LollobolUni/muon-time-dilation/mechanics/drawings/3DP-301_Block_enclosure_inserts.pdf

### TOP VIEW (looking down -Z) — inserts marked in red

Part file | 3DP-301_Block_enclosure.step
Part qty in order | 1
Material | 9600 Resin (white)
Insert type (JLC3DP table) | Type 1 — TTH-M3*6.25-HD4.7

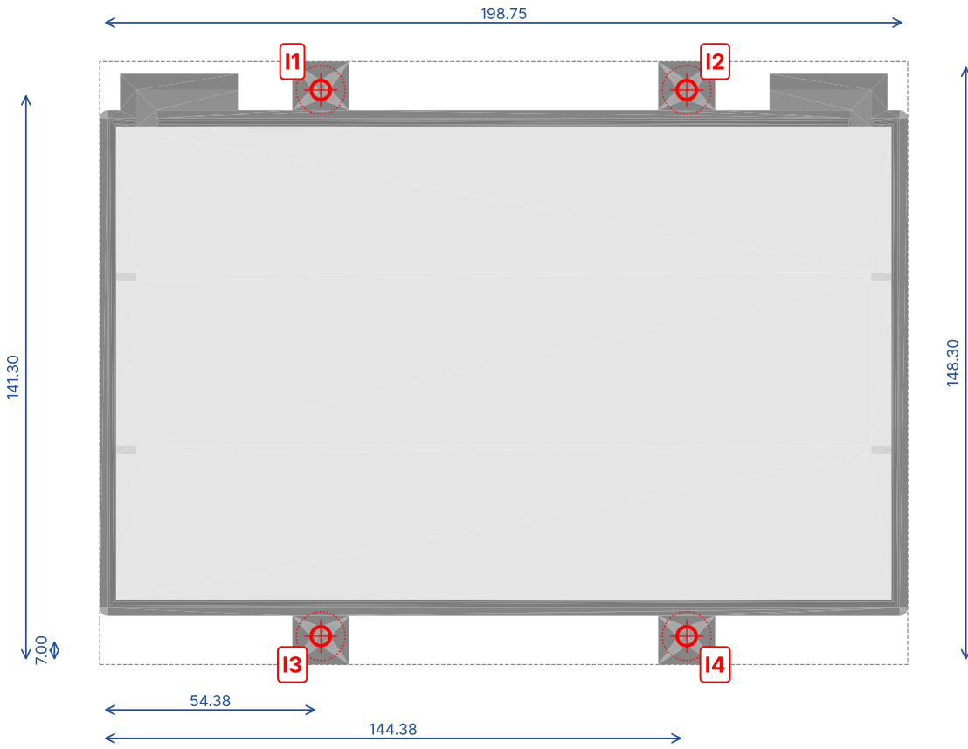
[picture p8: figure]

Thread | M3 (ID 3.0, OD 4.73, L 6.25)
Inserts per part | 4 (I1–I4)
Total inserts for this file | 4
Hole as modelled | Ø4.7 x 1.0 boss + Ø4.0 x 7.0 below = 8.0 total
Insert direction | From top (+Z), flush with face Z = 48.58
Insert | X from left edge Y from bottom edge | Z face
I1 | 54.38 | 141.30 | 48.58
I2 | 144.38 | 141.30 | 48.58
I3 | 54.38 | 7.00 | 48.58
I4 | 144.38 | 7.00 | 48.58

SECTION at Y = 141.30 from bottom edge (through I1/I2) — insert holes open upward

# 3DP-301 Block enclosure — threaded insert drawing (JLC3DP threaded insert service)

Lorenzo Bologna — muon-time-dilation project · units mm · 3DP-301_Block_enclosure.step · drawing generated from the uploaded model, same coordinates

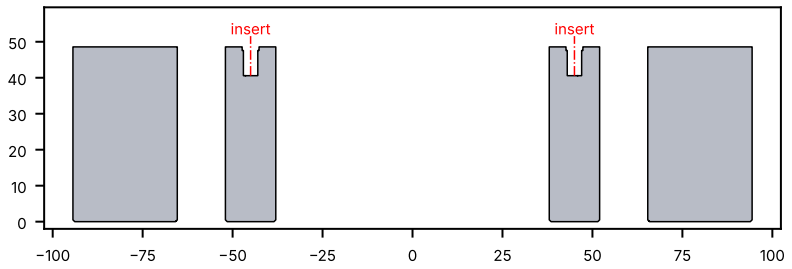
[picture p9: figure]
insert

Notes: install the 4 inserts I1-I4 flush with the face, from the open (+Z) side. No inserts in other holes. Holes = JLC3DP Type 1 (B 1.0, C 7.0, D 8.0).
