LollobolUni/muon-time-dilation/mechanics/assemblies/Tile_module_assembly.step

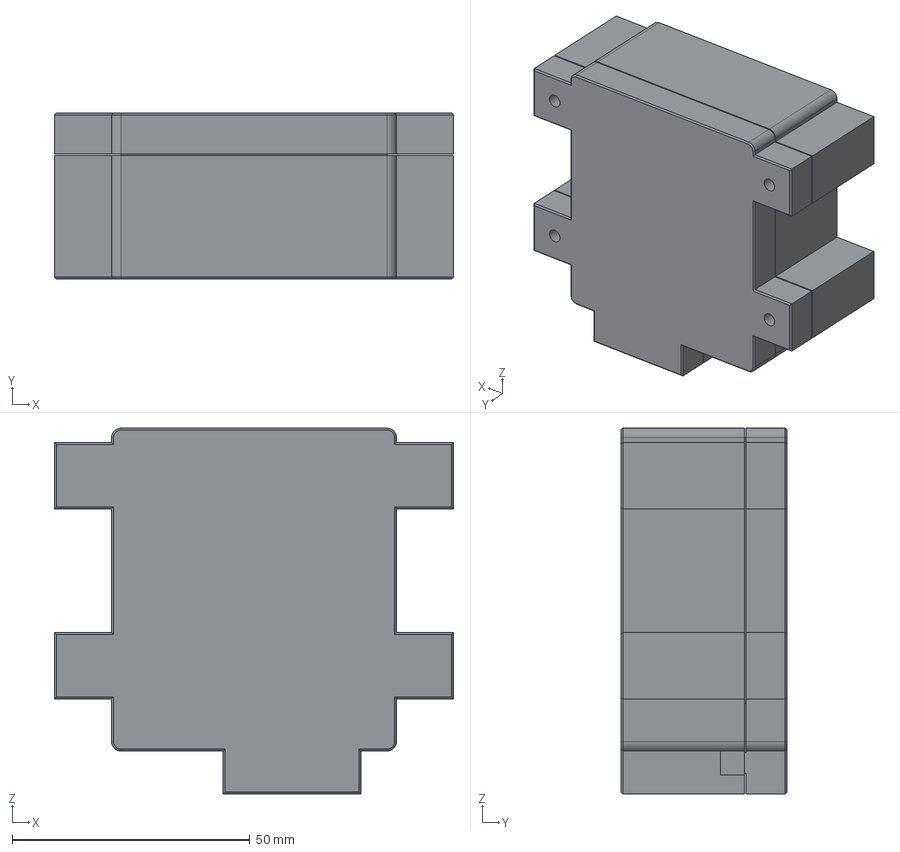
[picture p12: CAD file, 2026-11-06]
mechanics/assemblies/Tile_module_assembly.step
84.0 x 35.0 x 77.0 mm
3DP-311 Tile enclosure
3DP-313 SiPM holder
3DP-312 Tile lid
3DP-304 Spring cap
REF-202 BC408 tile
R_0805_2012Metric_11
PCB-401_front-end_channel_board_silkscreen x 267
PCB-401_front-end_channel_board_copper x 89
PCB-401_front-end_channel_board_soldermask x 2
PCB-401_front-end_channel_board_pad x 82
PCB-401_front-end_channel_board_via x 38
R_0805_2012Metric_2
R_0805_2012Metric_8
C_0805_2012Metric
SxB-PH-SM4-TB white_6 x 9
R_0805_2012Metric_9
512AG_512AG x 13
C_0805_2012Metric_3
R_0805_2012Metric_1
C_0805_2012Metric_8
C_0805_2012Metric_5
C_0805_2012Metric_10
PCB-401_front-end_channel_board_PCB
R_0805_2012Metric_6
C_0805_2012Metric_6
R_0805_2012Metric_3
R_0805_2012Metric_10
SOT-23
C_0805_2012Metric_9
C_0805_2012Metric_1
C_0805_2012Metric_4
R_0805_2012Metric_4
R_0805_2012Metric_7
SOT-23-6
C_0805_2012Metric_7
SOT-23-5
R_0805_2012Metric
R_0805_2012Metric_5
C_0805_2012Metric_2
R_0805_2012Metric_12
