LollobolUni/muon-time-dilation/mechanics/assemblies/Block_detector_assembly.step

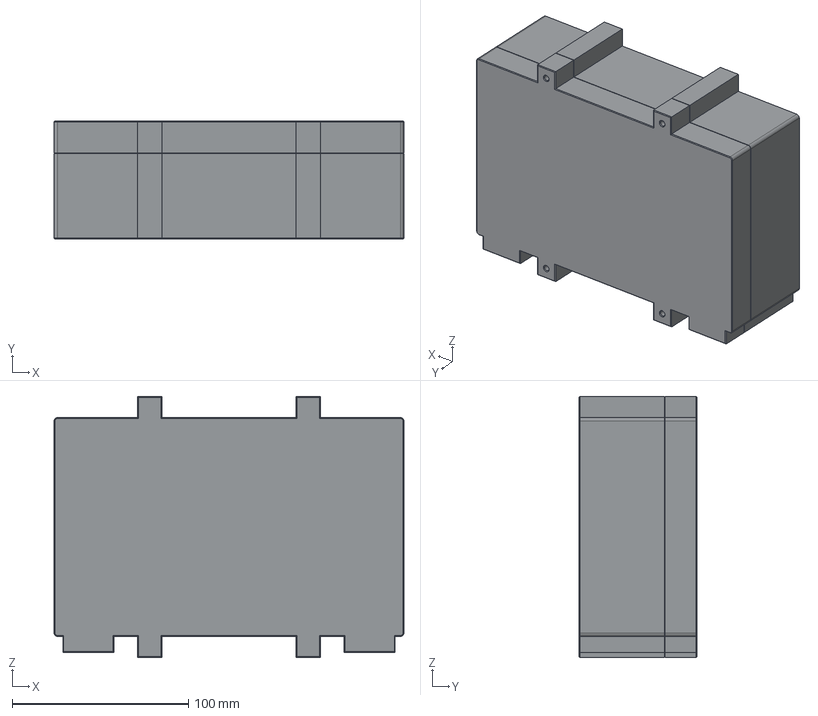
[picture p13: CAD file, 2026-11-06]
mechanics/assemblies/Block_detector_assembly.step
198.8 x 67.2 x 148.3 mm
REF-201 BC412 block
3DP-303 SiPM holder x 2
3DP-301 Block enclosure
3DP-302 Block lid
3DP-304 Spring cap x 2
PCB-401_front-end_channel_board_silkscreen x 534
PCB-401_front-end_channel_board_pad x 164
PCB-401_front-end_channel_board_copper x 178
SOT-23 x 2
PCB-401_front-end_channel_board_via x 76
SxB-PH-SM4-TB white_6 x 18
PCB-401_front-end_channel_board_soldermask x 4
C_0805_2012Metric x 2
512AG_512AG x 26
R_0805_2012Metric_3 x 2
C_0805_2012Metric_3 x 2
C_0805_2012Metric_9 x 2
R_0805_2012Metric_4 x 2
C_0805_2012Metric_7 x 2
SOT-23-6 x 2
C_0805_2012Metric_4 x 2
C_0805_2012Metric_2 x 2
PCB-401_front-end_channel_board_PCB x 2
R_0805_2012Metric_10 x 2
C_0805_2012Metric_10 x 2
R_0805_2012Metric_6 x 2
C_0805_2012Metric_5 x 2
R_0805_2012Metric_2 x 2
R_0805_2012Metric_9 x 2
R_0805_2012Metric_8 x 2
R_0805_2012Metric_12 x 2
R_0805_2012Metric_5 x 2
R_0805_2012Metric_11 x 2
R_0805_2012Metric_1 x 2
C_0805_2012Metric_8 x 2
C_0805_2012Metric_1 x 2
C_0805_2012Metric_6 x 2
R_0805_2012Metric x 2
R_0805_2012Metric_7 x 2
SOT-23-5 x 2
