LollobolUni/muon-time-dilation/mechanics/parts/3DP-313_SiPM_holder_tile.step

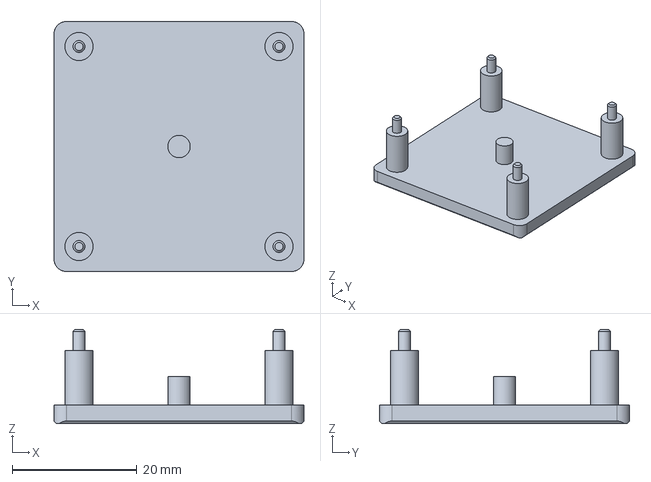
[picture p14: CAD file, 2026-11-06]
mechanics/parts/3DP-313_SiPM_holder_tile.step
40.0 x 40.0 x 15.1 mm
