LollobolUni/muon-time-dilation/mechanics/parts/3DP-301_Block_enclosure.step

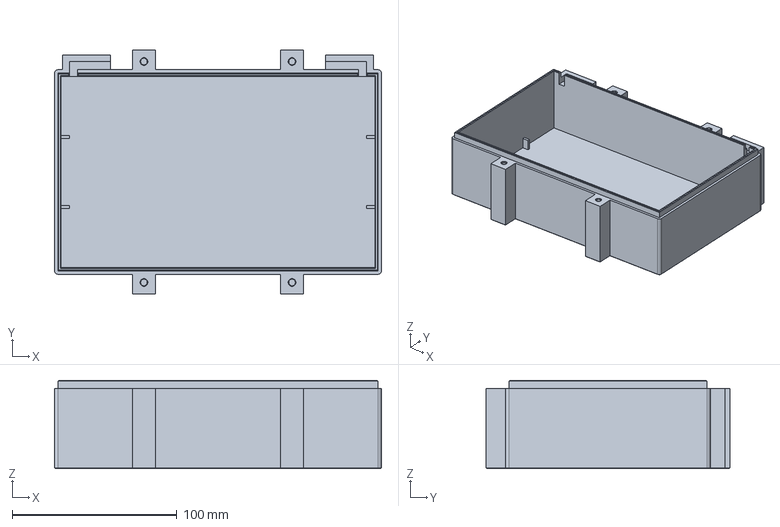
[picture p15: CAD file, 2026-11-06]
mechanics/parts/3DP-301_Block_enclosure.step
198.8 x 148.3 x 53.6 mm
