LollobolUni/muon-time-dilation/mechanics/parts/3DP-302_Block_lid.step

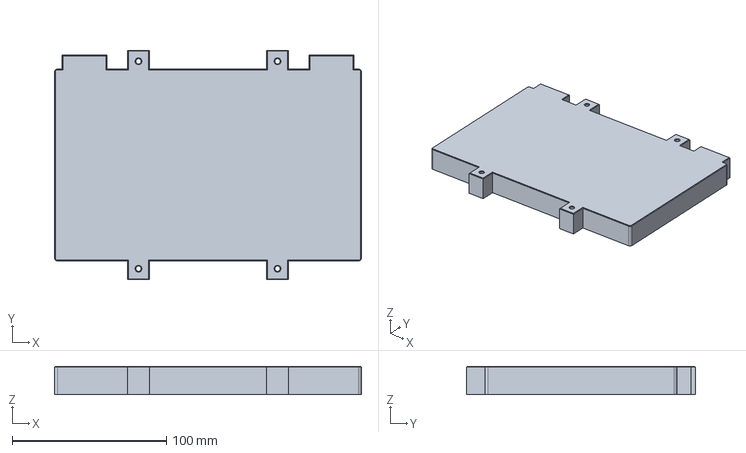
[picture p16: CAD file, 2026-11-06]
mechanics/parts/3DP-302_Block_lid.step
198.8 x 148.3 x 18.3 mm
