LollobolUni/muon-time-dilation/mechanics/parts/3DP-312_Tile_lid.step

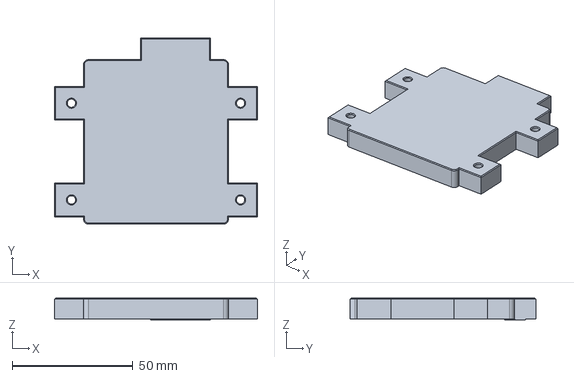
[picture p17: CAD file, 2026-11-06]
mechanics/parts/3DP-312_Tile_lid.step
84.0 x 77.0 x 9.00 mm
