LollobolUni/muon-time-dilation/mechanics/parts/3DP-311_Tile_enclosure.step

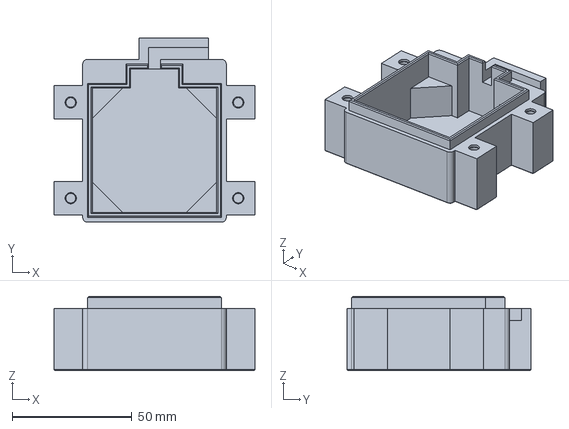
[picture p18: CAD file, 2026-11-06]
mechanics/parts/3DP-311_Tile_enclosure.step
84.0 x 77.0 x 31.0 mm
