LollobolUni/muon-time-dilation/mechanics/parts/3DP-303_SiPM_holder_block.step

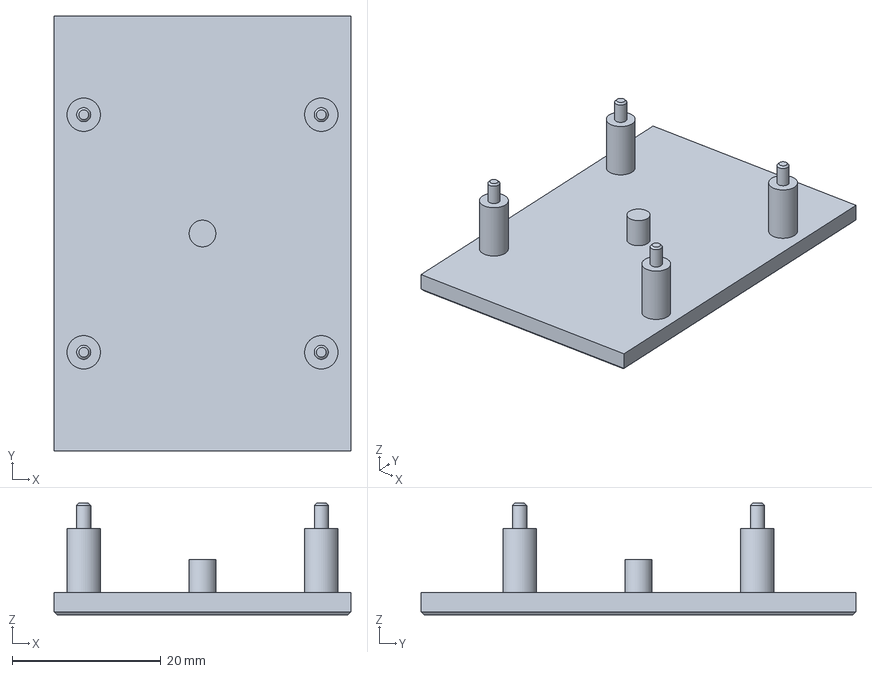
[picture p19: CAD file, 2026-11-06]
mechanics/parts/3DP-303_SiPM_holder_block.step
40.0 x 58.5 x 15.1 mm
