LollobolUni/muon-time-dilation/mechanics/parts/3DP-304_Spring_cap_x4_connected.step

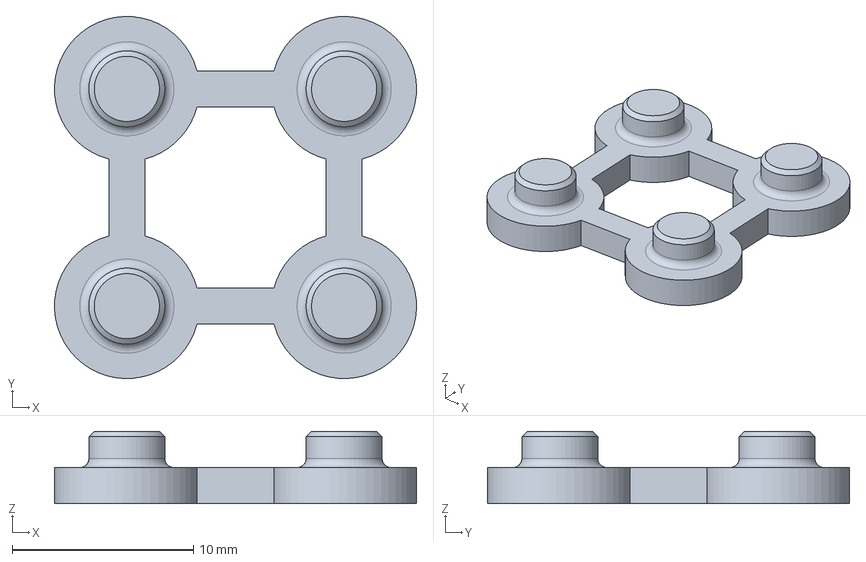
[picture p20: CAD file, 2026-11-06]
mechanics/parts/3DP-304_Spring_cap_x4_connected.step
20.0 x 20.0 x 4.00 mm
