LollobolUni/muon-time-dilation/hardware/schematics/PCB-401_channel-board_v0.2.pdf

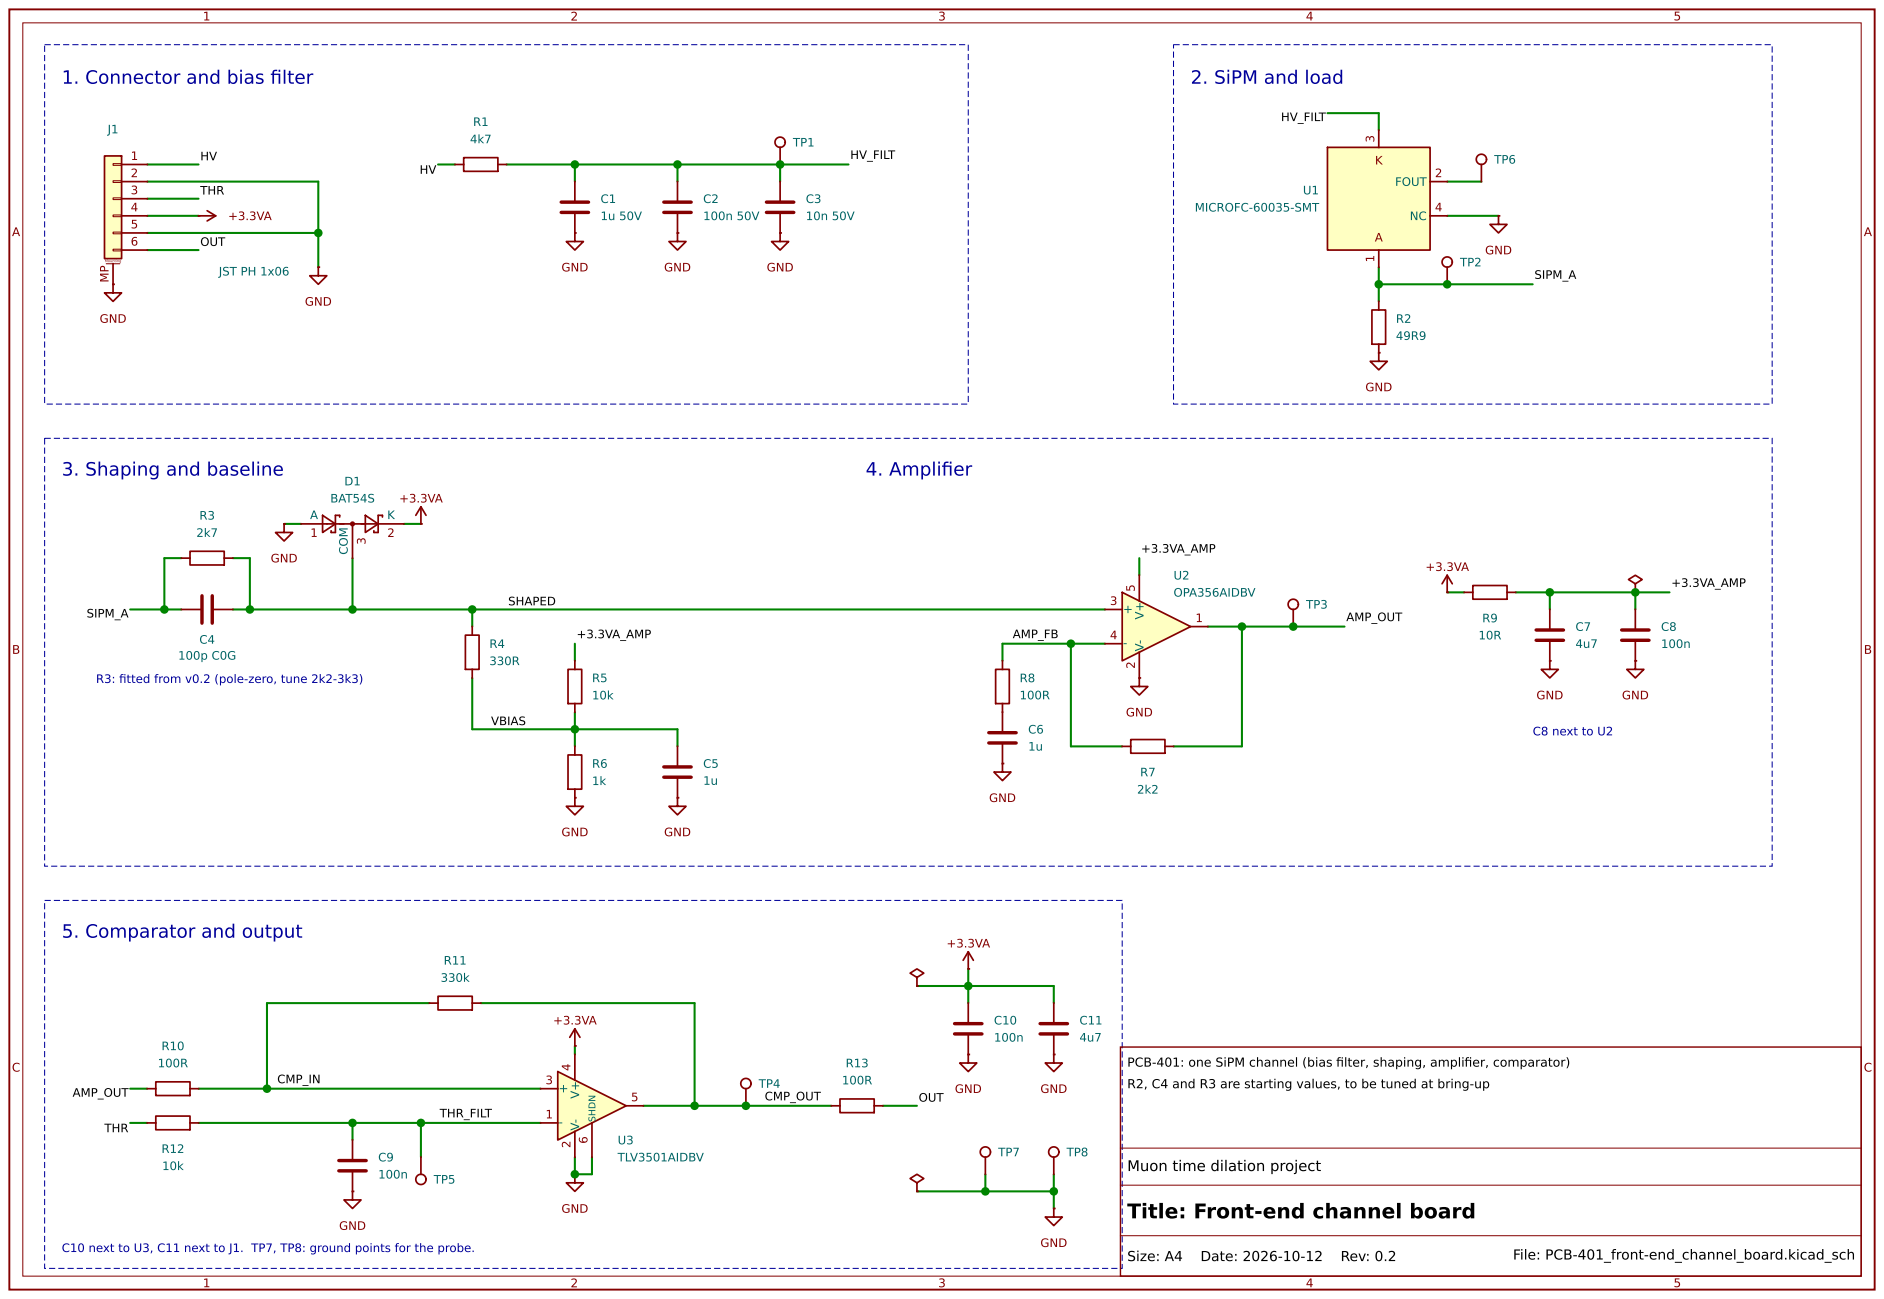
[picture p21: page 1]

1. Connector and bias filter

R3: fitted from v0.2 (pole-zero, tune 2k2-3k3)

PCB-401: one SiPM channel (bias filter, shaping, amplifier, comparator)

R2, C4 and R3 are starting values, to be tuned at bring-up

Muon time dilation project
Title: Front-end channel board

C10 next to U3, C11 next to J1. TP7, TP8: ground points for the probe.

R10

R9

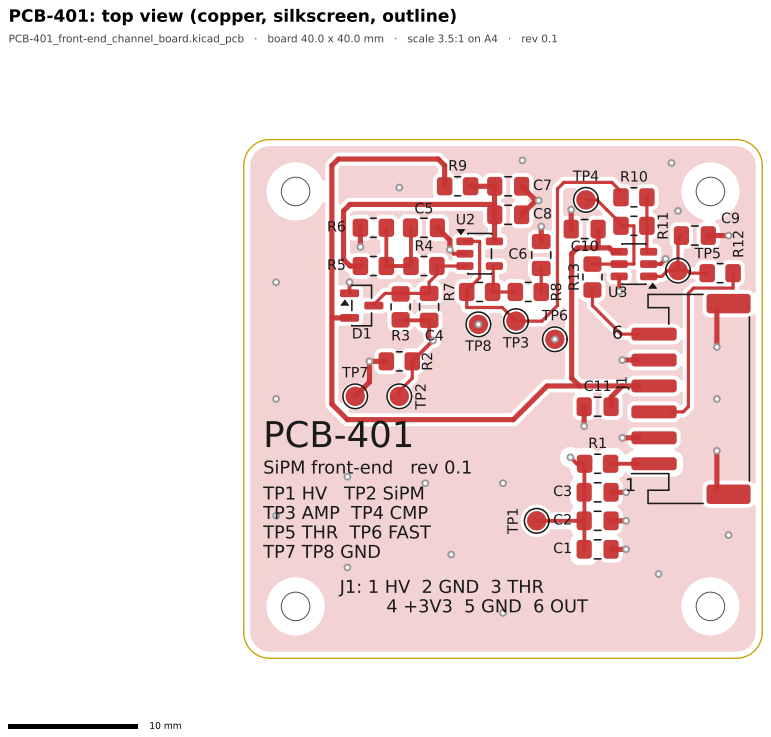
[picture p22: page 2]

PCB-401: top view (copper, silkscreen, outline)

PCB-401_front-end_channel_board.kicad_pcb · board 40.0 x 40.0 mm · scale 3.5:1 on A4 · rev 0.1

SiPM front-end rev 0.1
TP1 HV TP2 SiPM
TP3 AMP TP4 CMP
TP5 THR TP6 FAST
TP7 TP8 GND

# PCB-401: bottom view, mirrored (as seen when the board is flipped)

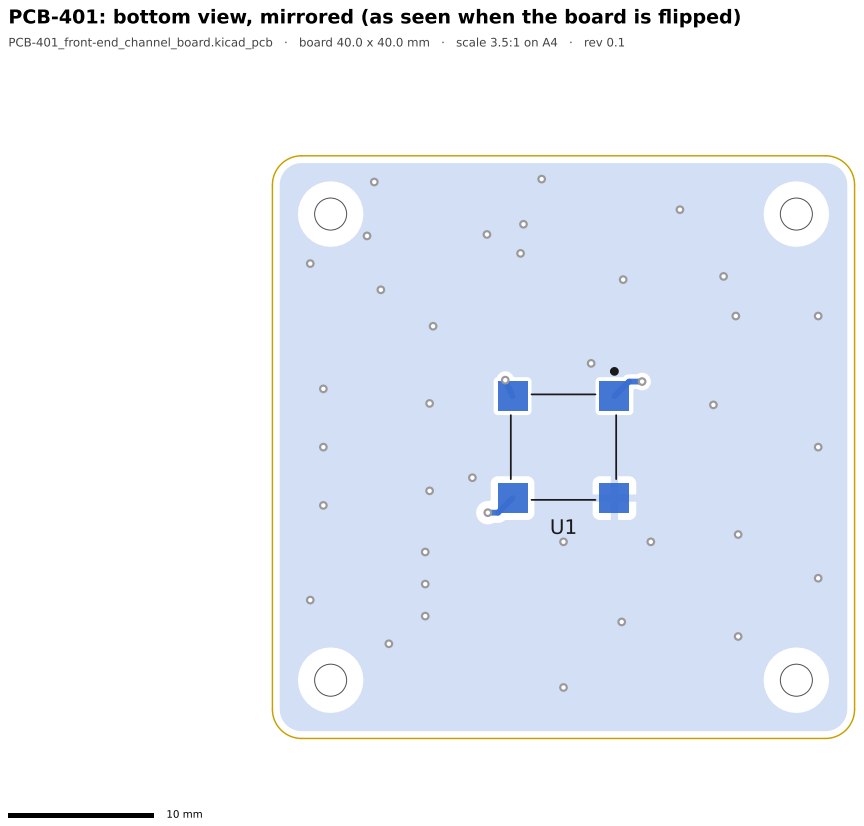
[picture p23: page 3]

# PCB-401: top copper (F.Cu) with net names on the pads

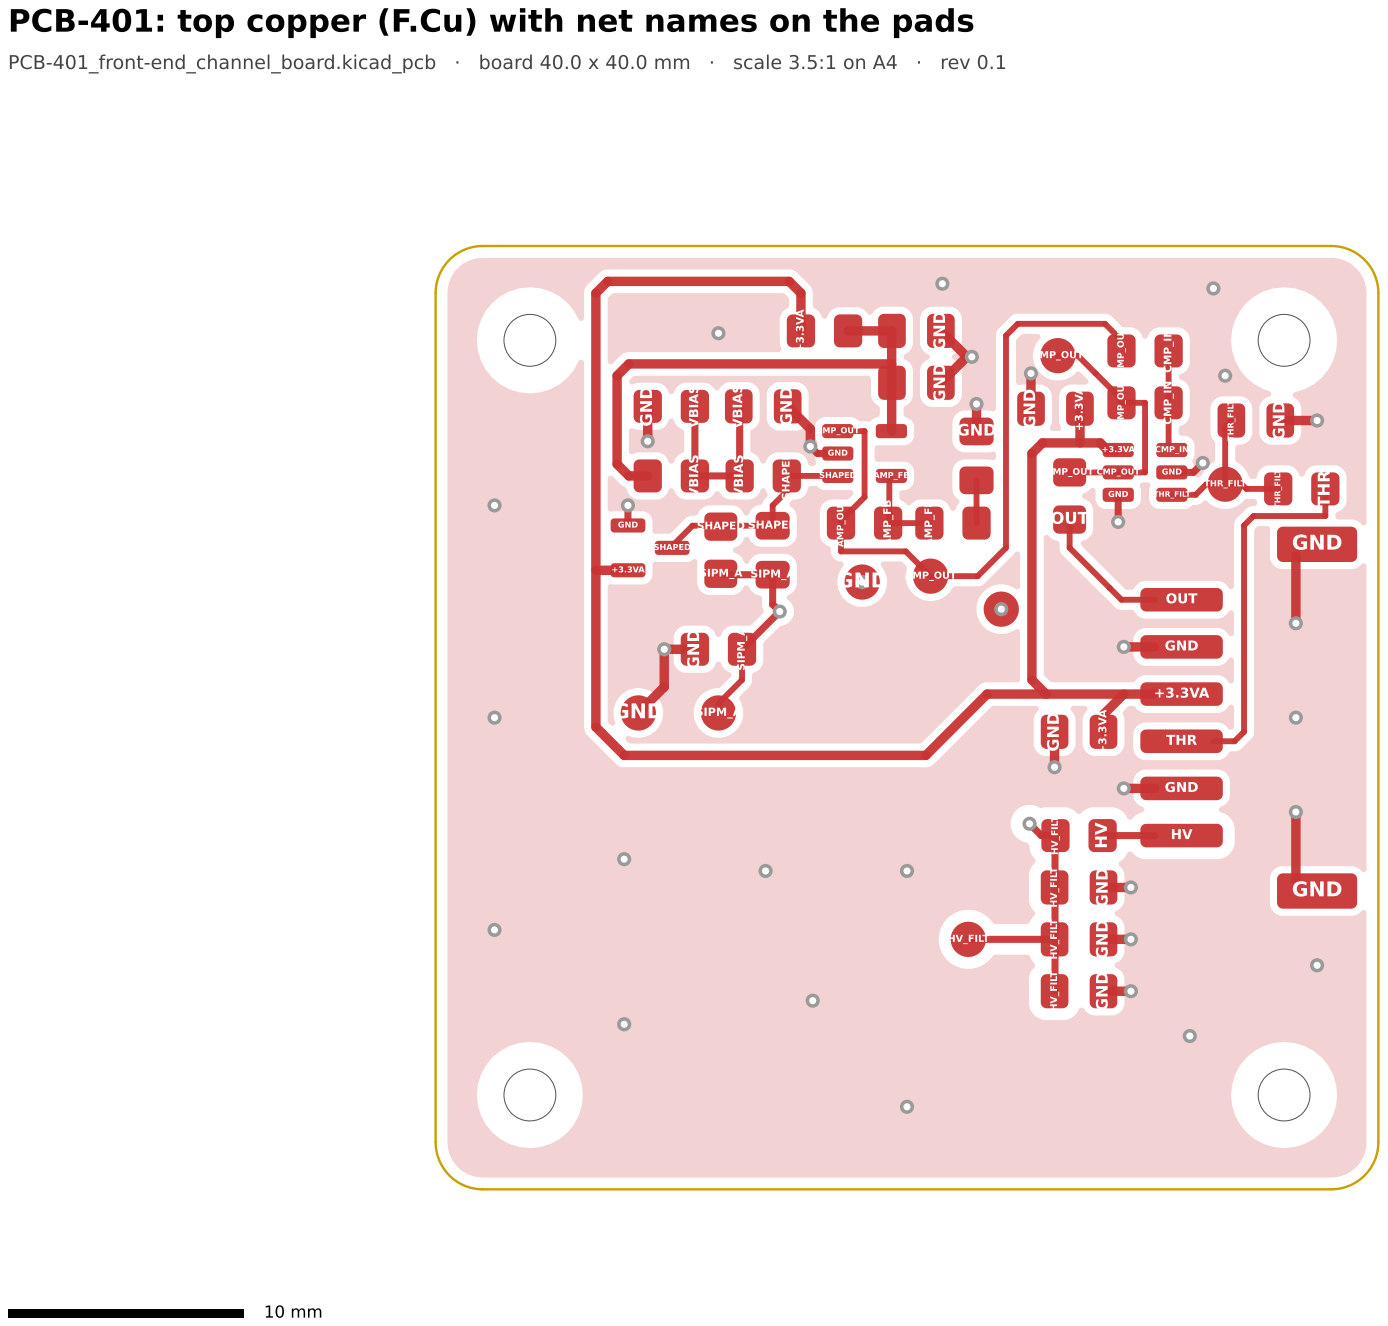
[picture p24: page 4]
THR_FILT; HV_FILT; GND; AMP_FB; AMP_OUT; SHAPED; SIPM_A; VBIAS; CMP_IN; CMP_OUT; THR; OUT

# PCB-401: bottom copper (B.Cu), mirrored, with net names on the pads

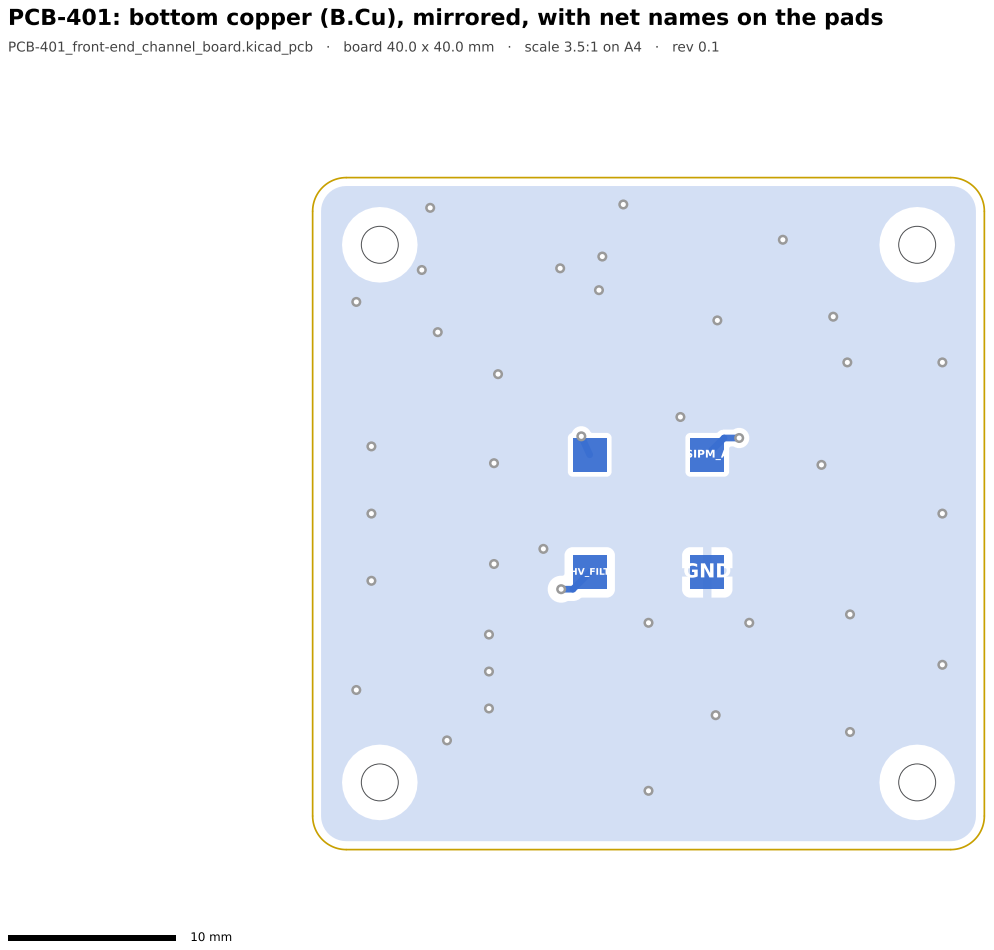
[picture p25: page 5]
SIPM_A; HV_FILT; GND

TP4

# PCB-401: top-side assembly (references and component outlines)

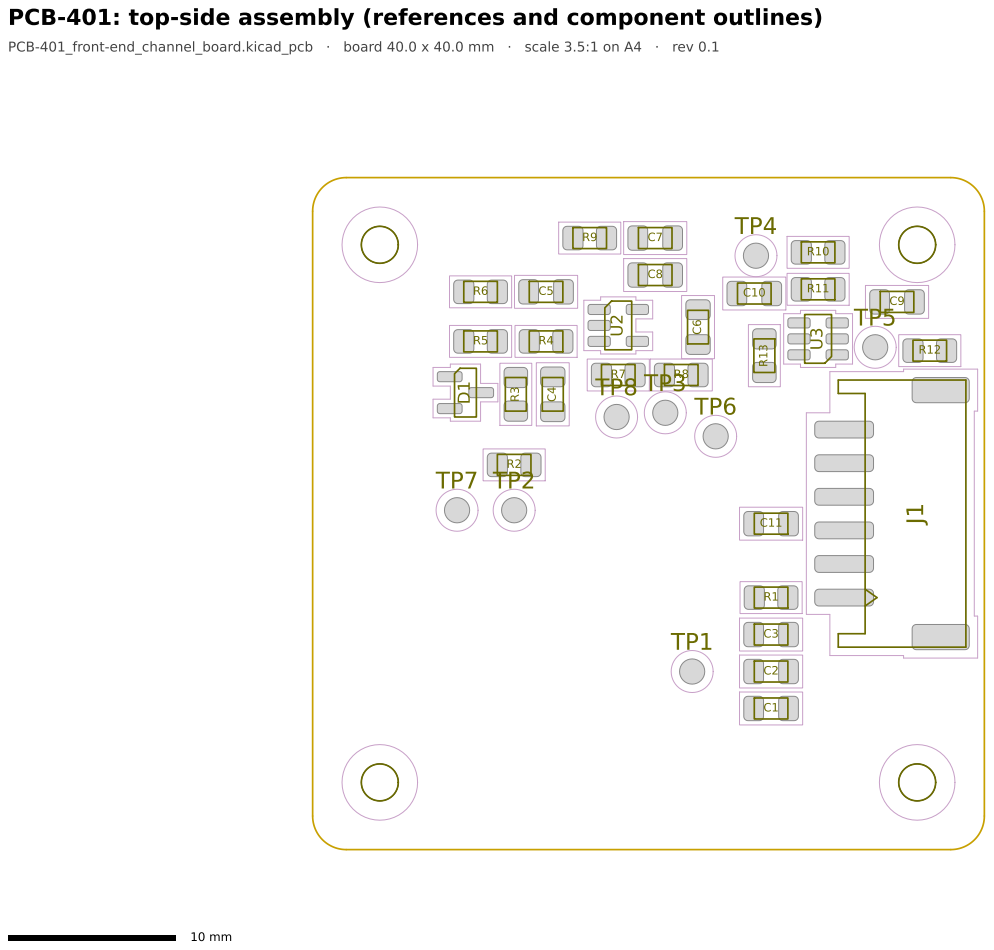
[picture p26: page 6]

# PCB-401: bottom-side assembly, mirrored

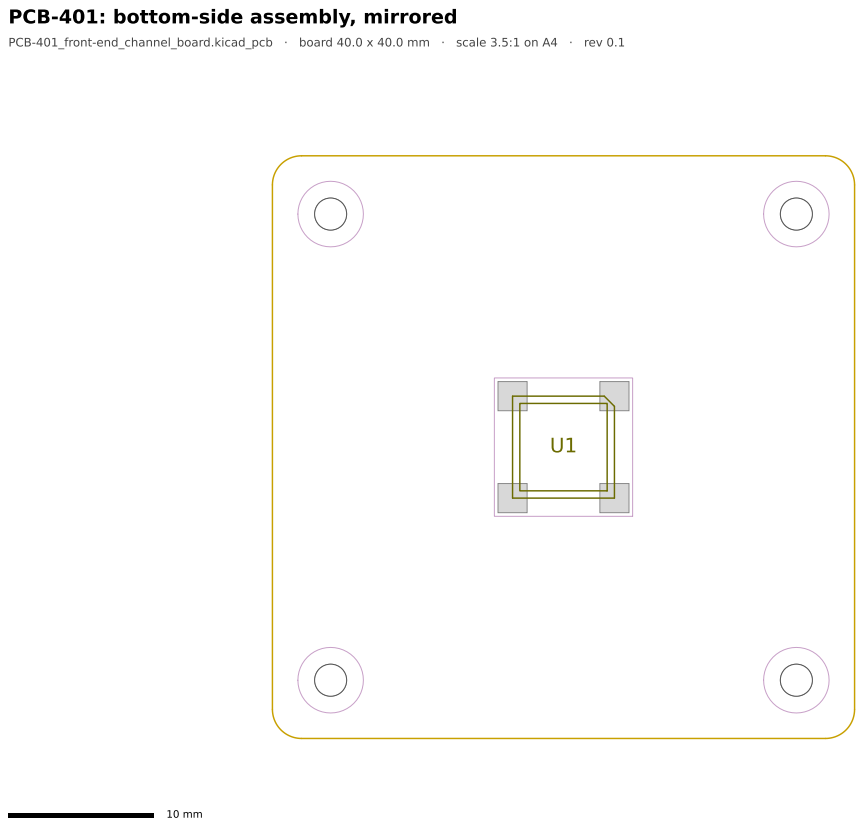
[picture p27: page 7]
