LollobolUni/muon-time-dilation/hardware/schematics/PCB-402_base-board_v0.1.pdf

## 1. 5 V input and 3.3 V analog supply

## 2. SiPM bias: MAX5026 step-up, 22 - 28 V

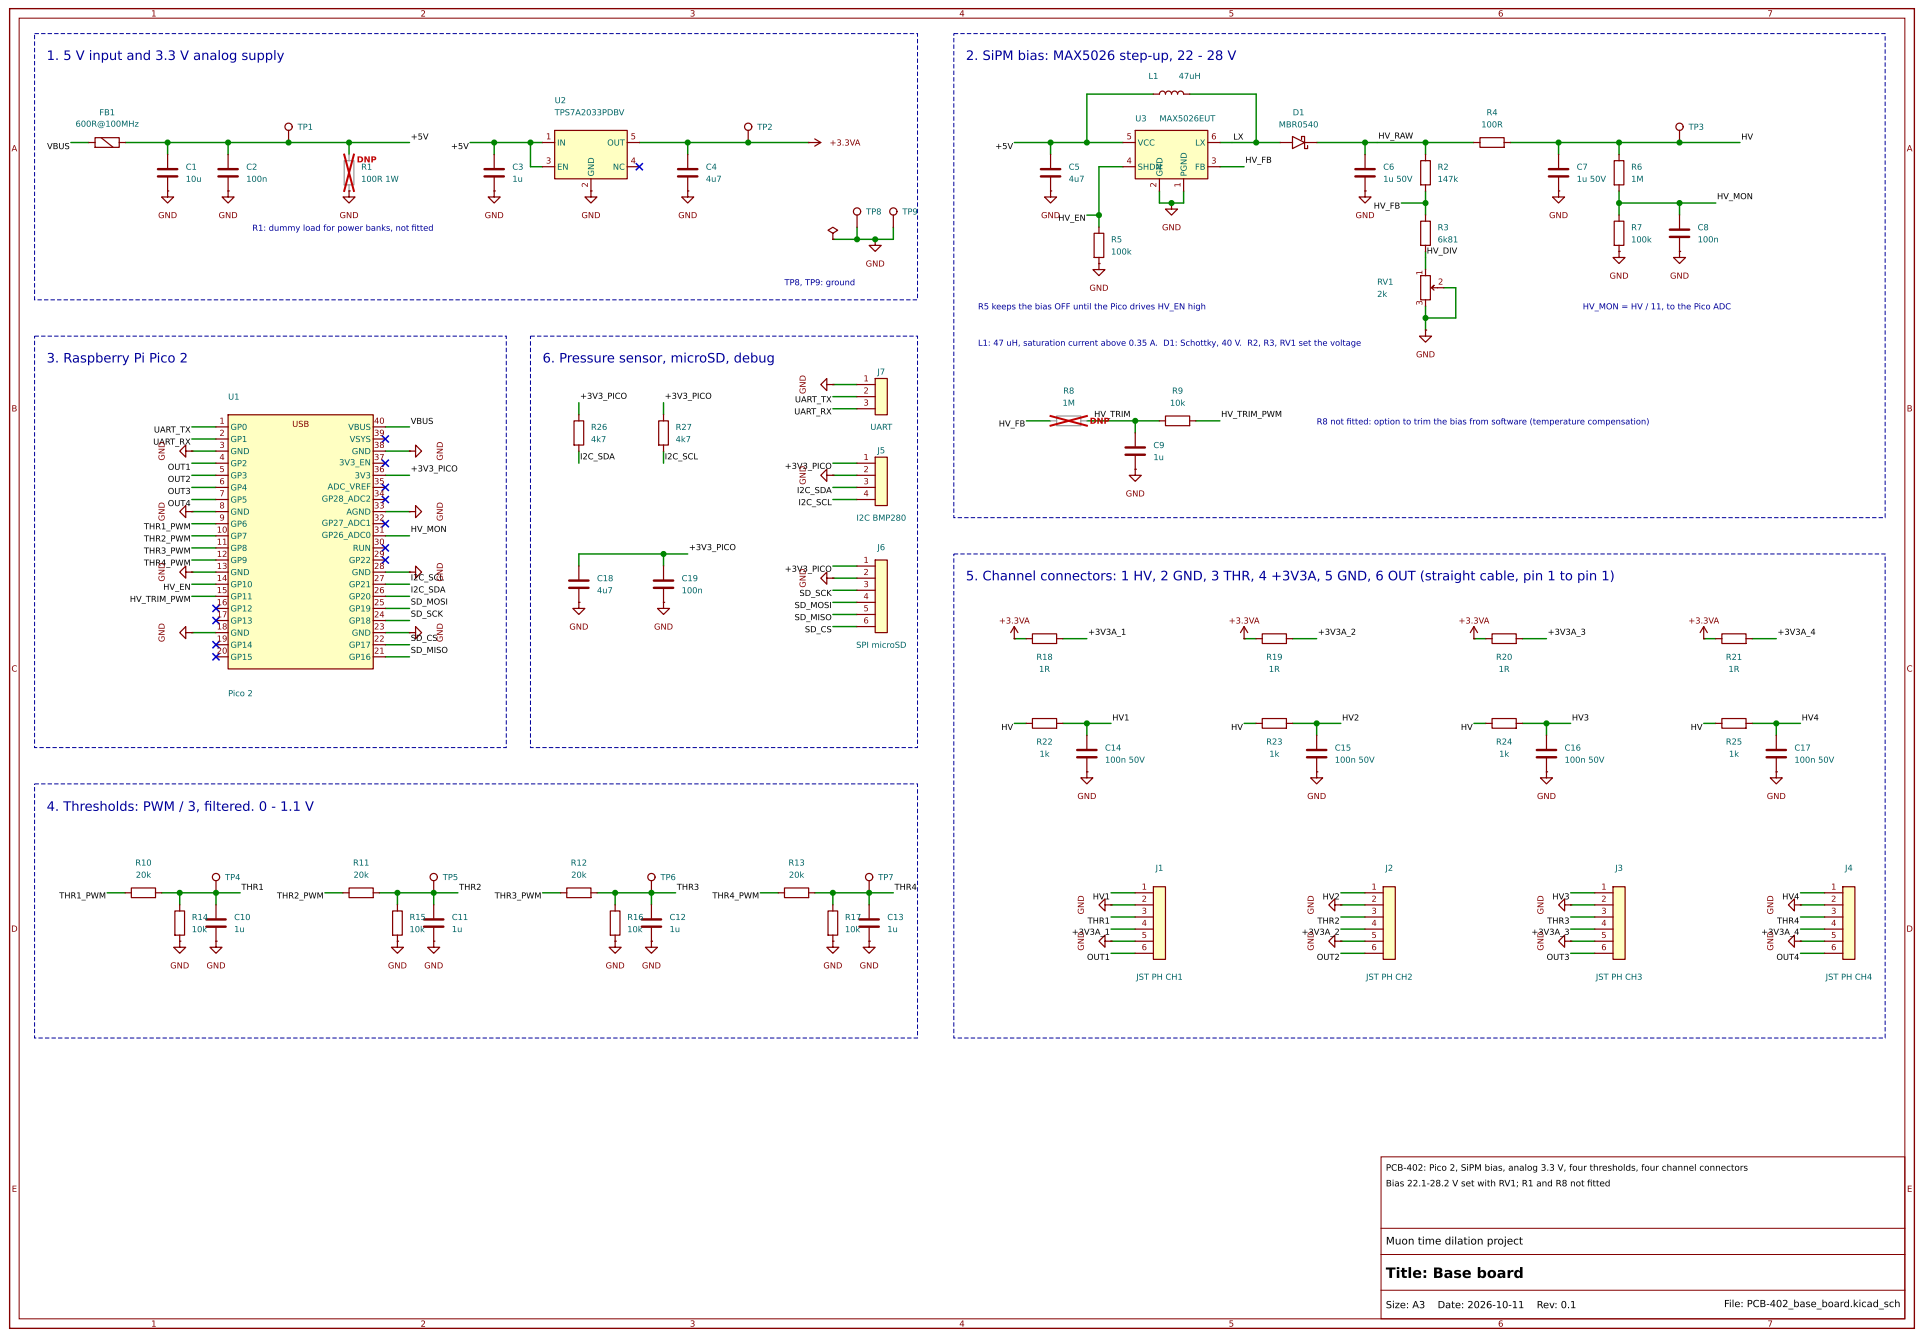
[picture p28: page 1]

R1: dummy load for power banks, not fitted

R5 keeps the bias OFF until the Pico drives HV_EN high

HV_MON = HV / 11, to the Pico ADC

L1: 47 uH, saturation current above 0.35 A. D1: Schottky, 40 V. R2, R3, RV1 set the voltage

R8 not fitted: option to trim the bias from software (temperature compensation)

GND GND

5. Channel connectors: 1 HV, 2 GND, 3 THR, 4 +3V3A, 5 GND, 6 OUT (straight cable, pin 1 to pin 1)

PCB-402: Pico 2, SiPM bias, analog 3.3 V, four thresholds, four channel connectors
Bias 22.1-28.2 V set with RV1; R1 and R8 not fitted

Muon time dilation project
Title: Base board

+5V
J7

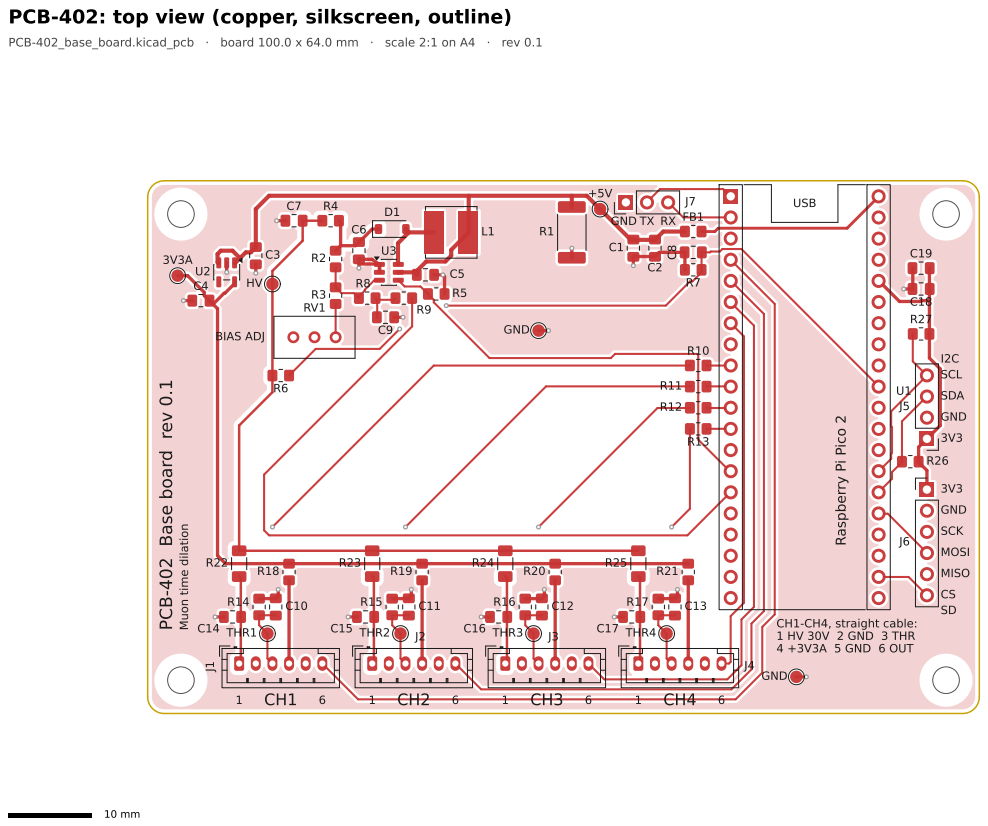
[picture p29: page 2]

PCB-402: top view (copper, silkscreen, outline)

PCB-402_base_board.kicad_pcb · board 100.0 x 64.0 mm · scale 2:1 on A4 · rev 0.1

PCB-402 Base board rev 0.1

# PCB-402: bottom view, mirrored (as seen when the board is flipped)

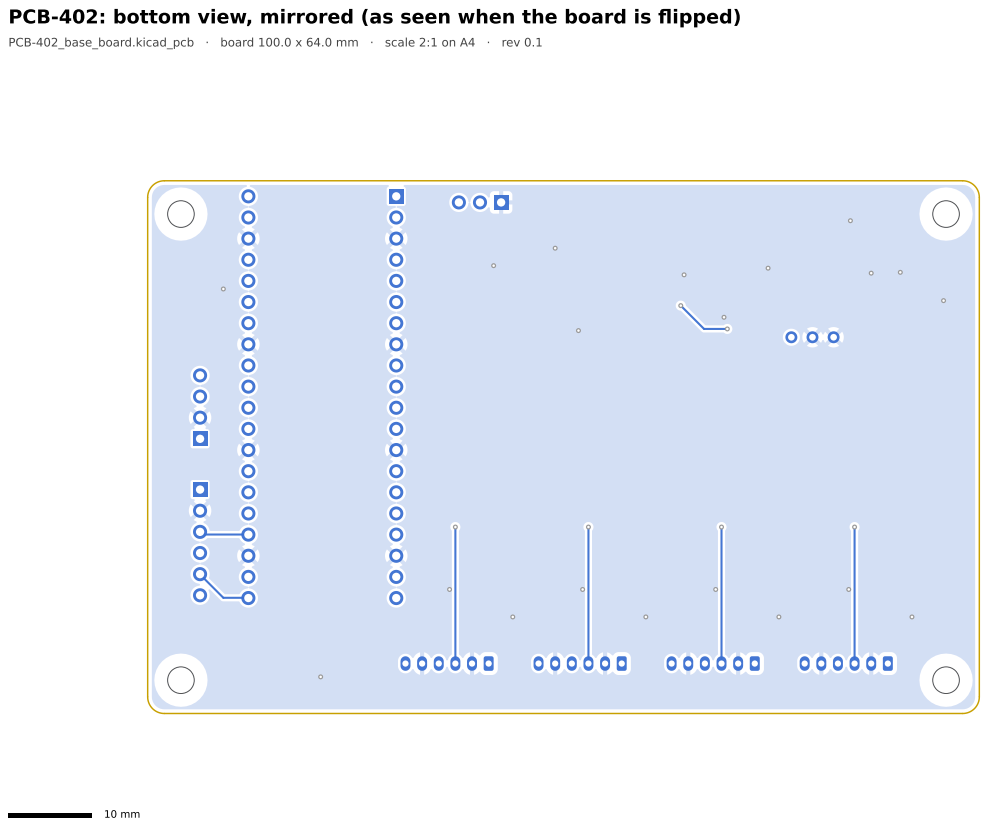
[picture p30: page 3]

# GND

## VBUS

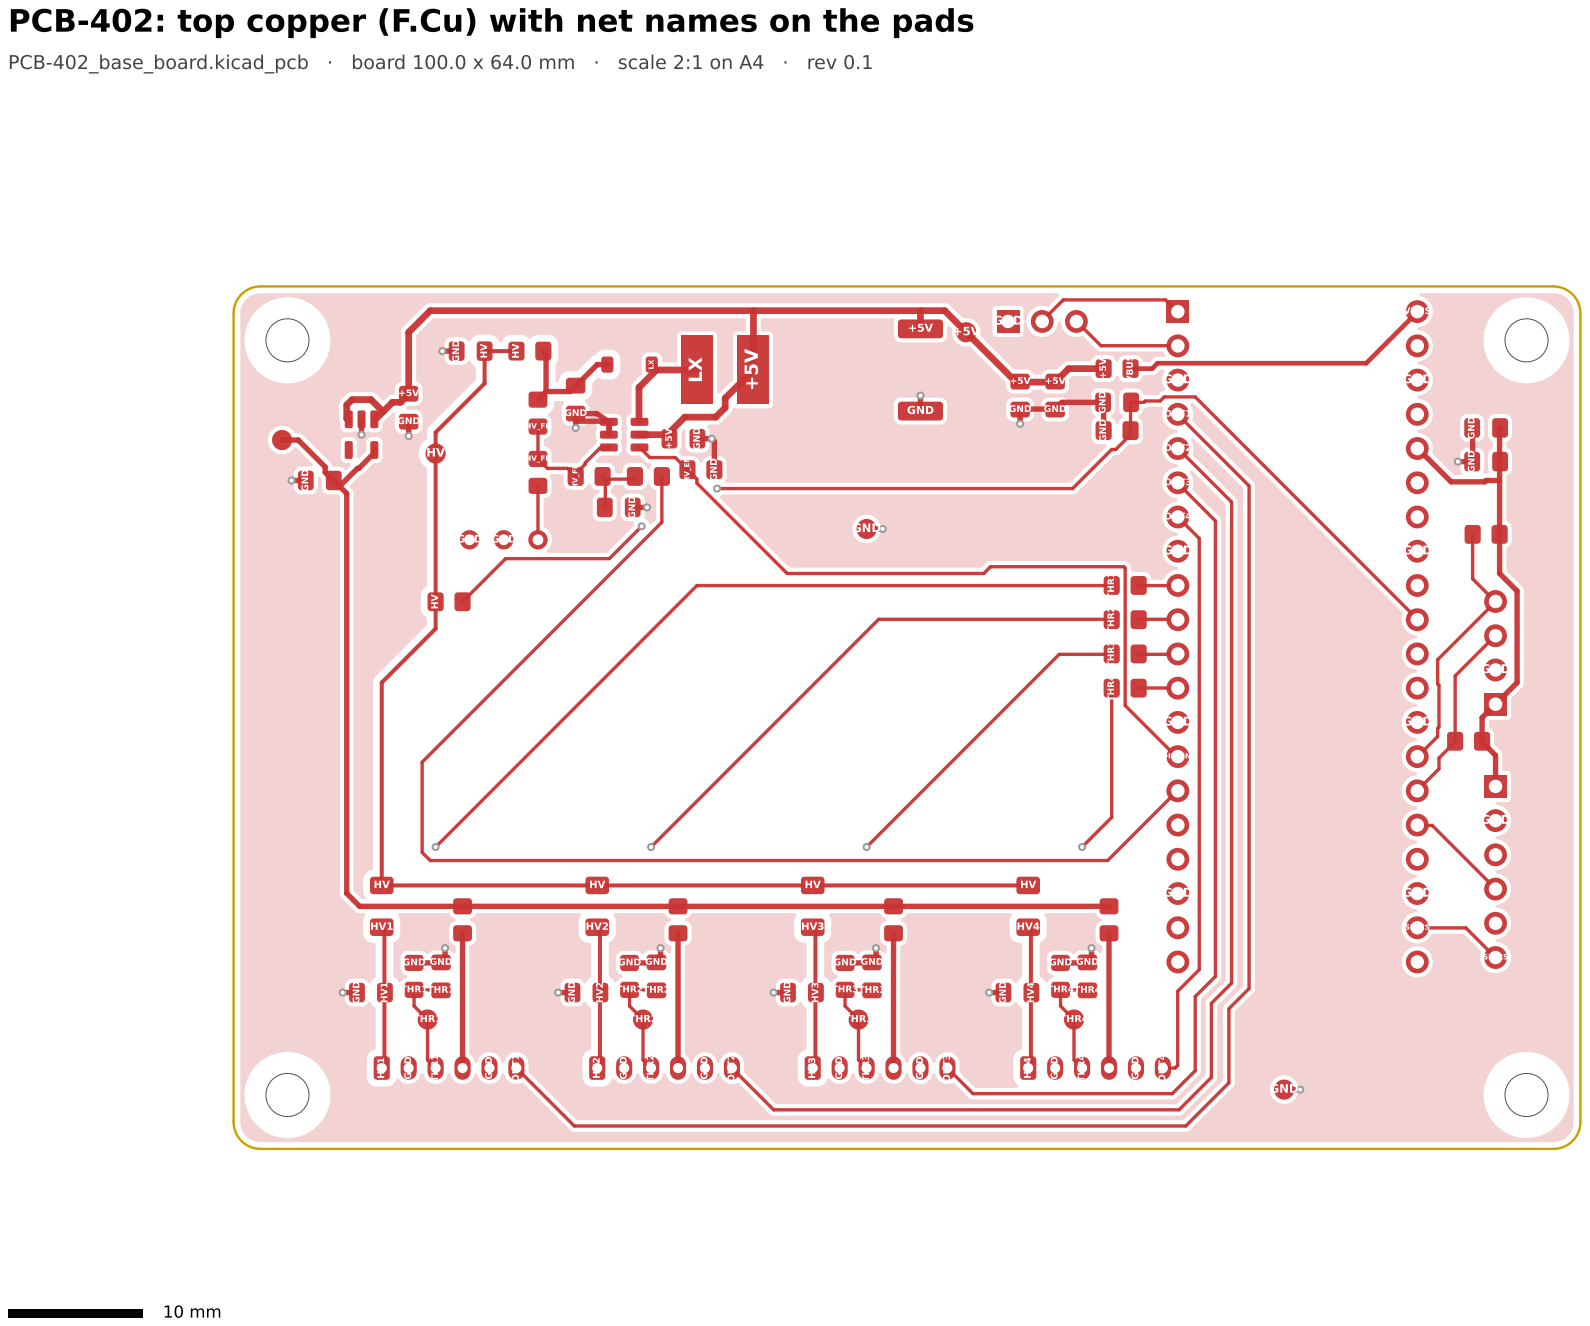
[picture p31: page 4]
THR4; GND; THR2; THR3; HV1HV¹; THR1; OUT1; OUT2; VBUS; OUT4; OUT3

PCB-402: top copper (F.Cu) with net names on the pads

GND
GND GND HV

# GND

## VBUS

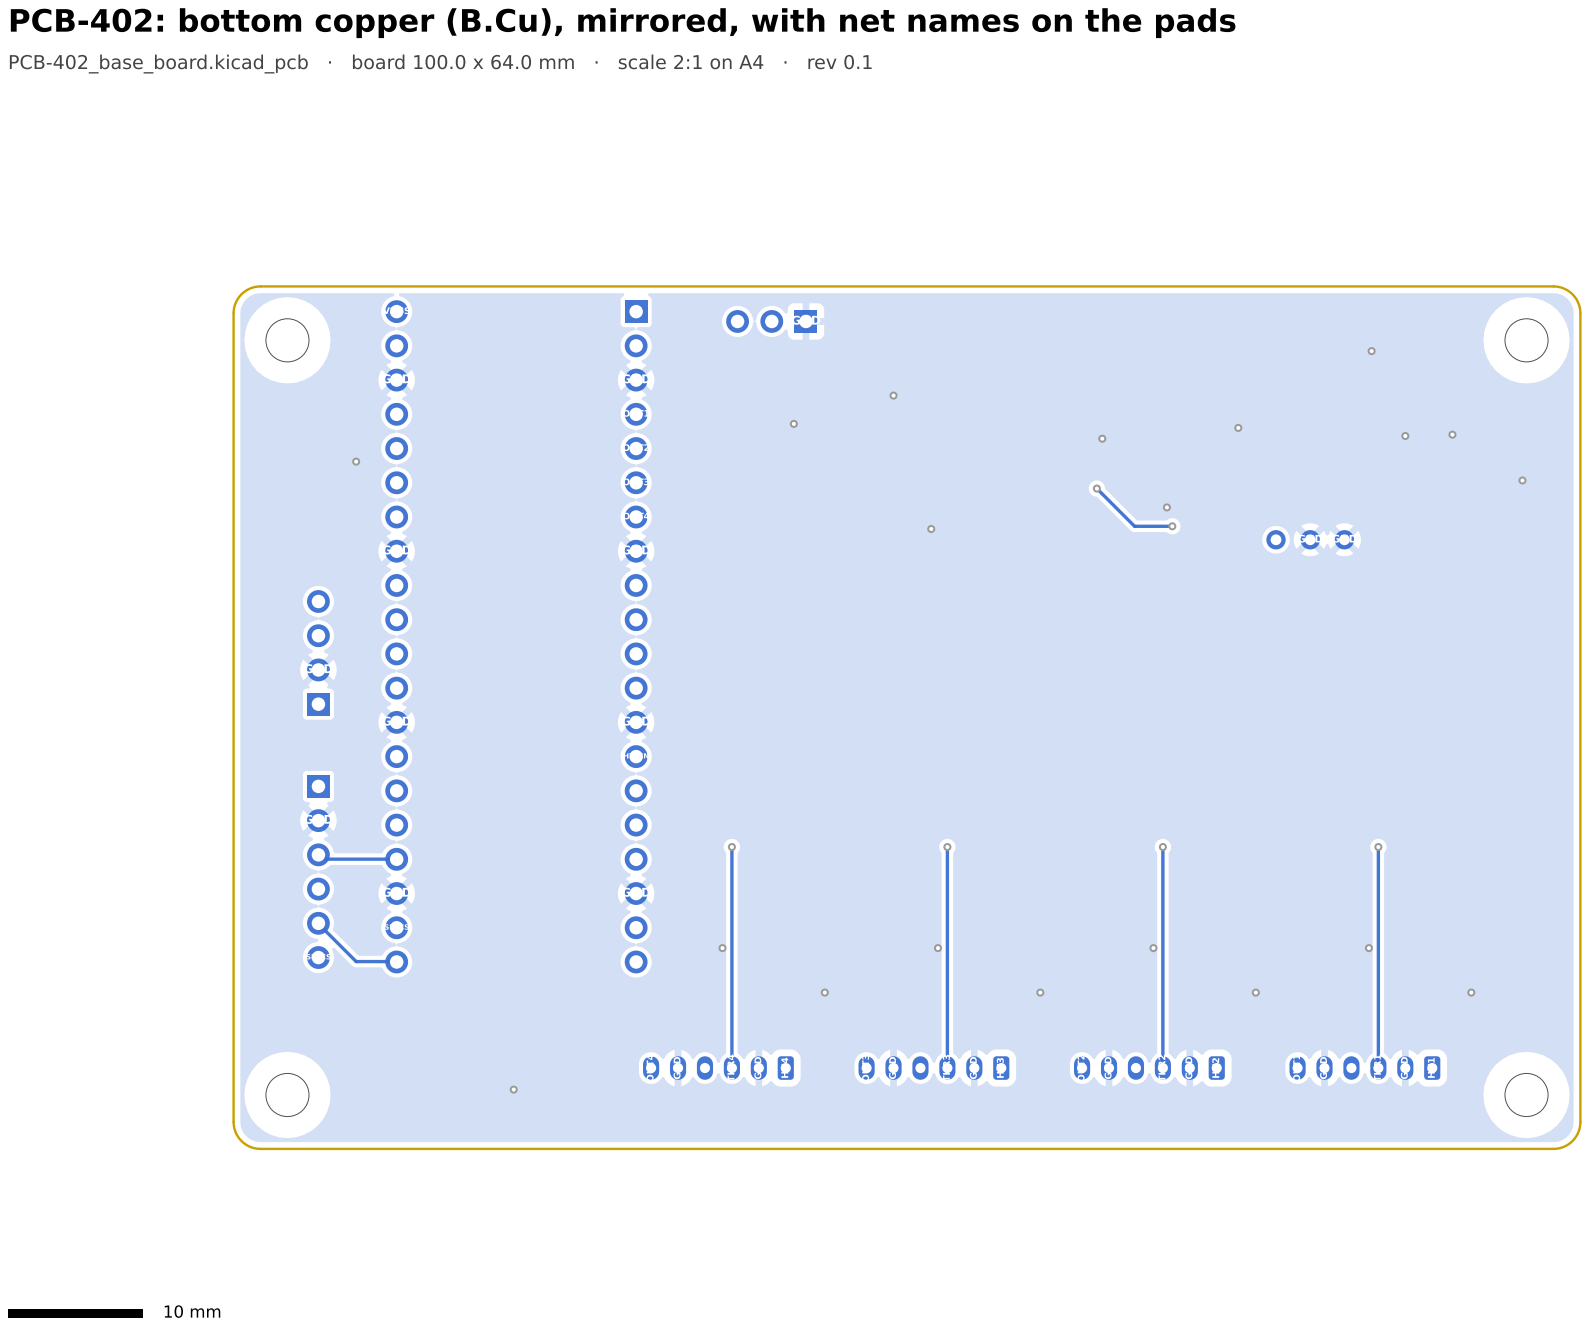
[picture p32: page 5]
GND; OUT1; THR1; GND GND; OUT4; THR4; OUT2; THR2; OUT3; THR3

PCB-402: bottom copper (B.Cu), mirrored, with net names on the pads

J7

## TP1 TP1

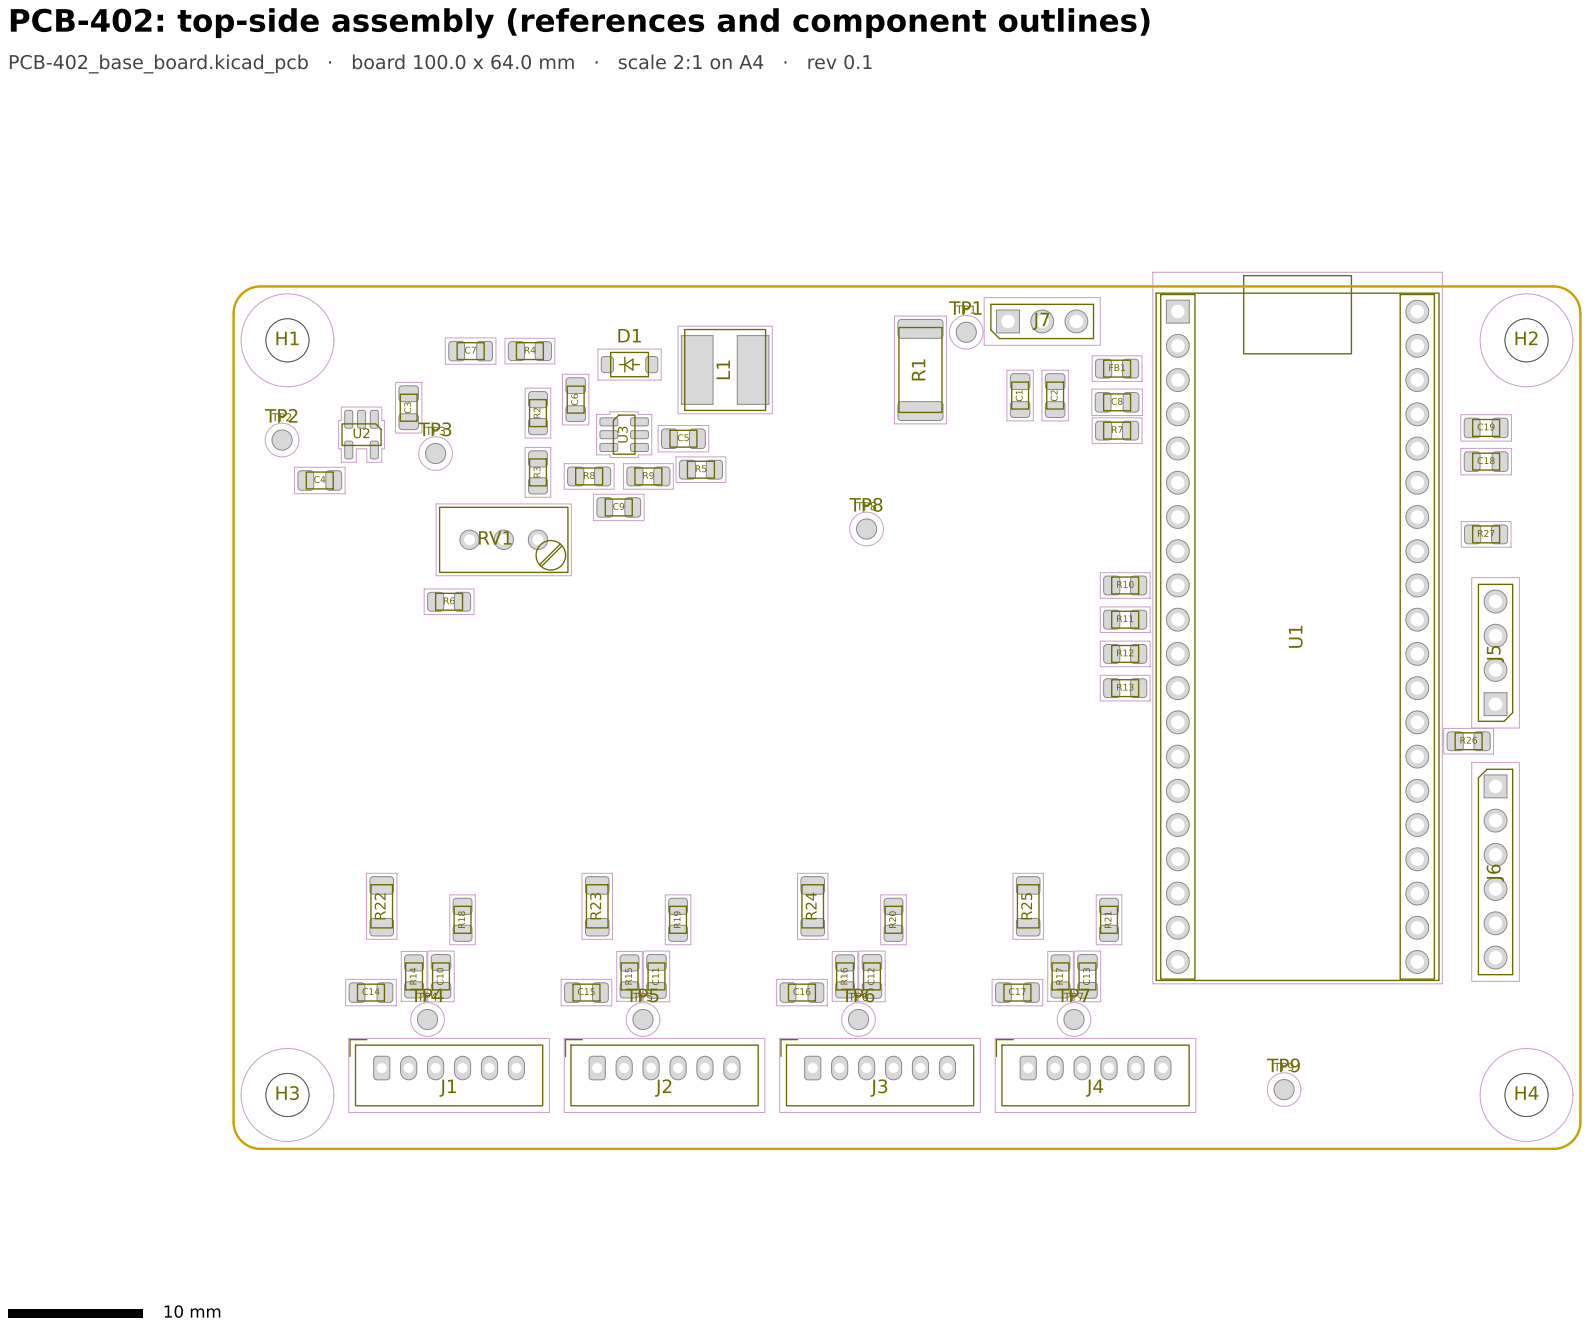
[picture p33: page 6]

PCB-402: top-side assembly (references and component outlines)
