LollobolUni/muon-time-dilation/hardware/kicad/PCB-402_base_board/PCB-402_base_board.kicad_pcb

## KiCad design hardware/kicad/PCB-402_base_board/PCB-402_base_board.kicad_pcb (2026-11-06)

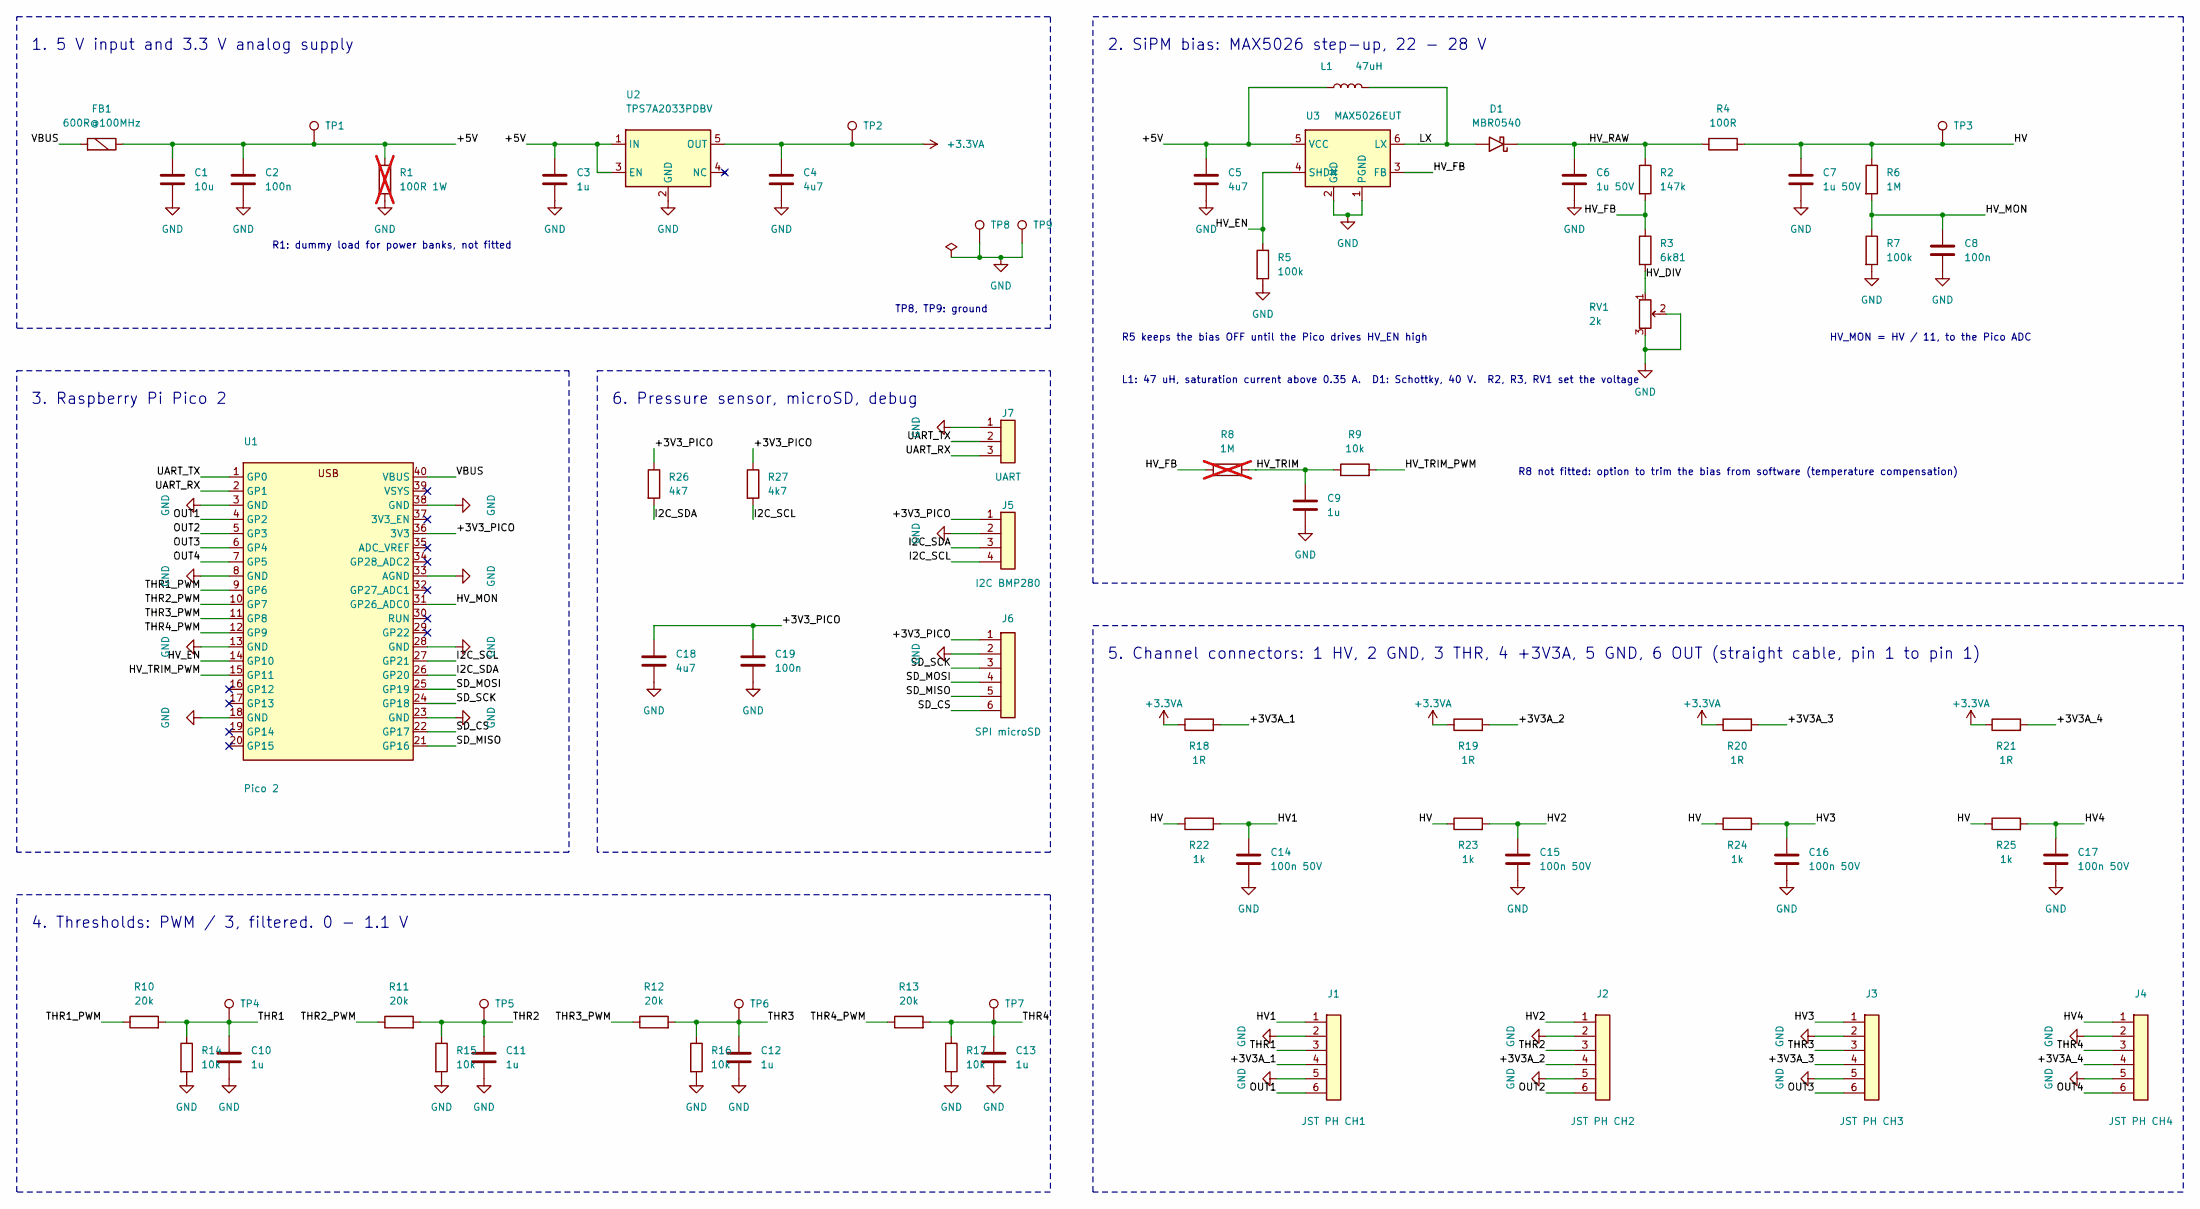
[picture p34: schematic PCB-402_base_board.kicad_sch, Base board]

Parts:
C1: 10u; C_0805_2012Metric_Pad1.18x1.45mm_HandSolder
C2, C8, C19: 100n; C_0805_2012Metric_Pad1.18x1.45mm_HandSolder
C3, C9, C10, C11, C12, C13: 1u; C_0805_2012Metric_Pad1.18x1.45mm_HandSolder
C4, C5, C18: 4u7; C_0805_2012Metric_Pad1.18x1.45mm_HandSolder
C6, C7: 1u 50V; C_0805_2012Metric_Pad1.18x1.45mm_HandSolder
C14, C15, C16, C17: 100n 50V; C_0805_2012Metric_Pad1.18x1.45mm_HandSolder
D1: MBR0540; D_SOD-123
FB1: 600R@100MHz; R_0805_2012Metric_Pad1.20x1.40mm_HandSolder
J1: JST PH CH1; JST_PH_B6B-PH-K_1x06_P2.00mm_Vertical
J2: JST PH CH2; JST_PH_B6B-PH-K_1x06_P2.00mm_Vertical
J3: JST PH CH3; JST_PH_B6B-PH-K_1x06_P2.00mm_Vertical
J4: JST PH CH4; JST_PH_B6B-PH-K_1x06_P2.00mm_Vertical
J5: I2C BMP280; PinHeader_1x04_P2.54mm_Vertical
J6: SPI microSD; PinHeader_1x06_P2.54mm_Vertical
J7: UART; PinHeader_1x03_P2.54mm_Vertical
L1: 47uH; L_Bourns_SRN6045TA
R1: 100R 1W; R_2512_6332Metric_Pad1.40x3.35mm_HandSolder; not fitted
R2: 147k; R_0805_2012Metric_Pad1.20x1.40mm_HandSolder
R3: 6k81; R_0805_2012Metric_Pad1.20x1.40mm_HandSolder
R4: 100R; R_0805_2012Metric_Pad1.20x1.40mm_HandSolder
R5, R7: 100k; R_0805_2012Metric_Pad1.20x1.40mm_HandSolder
R6: 1M; R_0805_2012Metric_Pad1.20x1.40mm_HandSolder
R8: 1M; R_0805_2012Metric_Pad1.20x1.40mm_HandSolder; not fitted
R9, R14, R15, R16, R17: 10k; R_0805_2012Metric_Pad1.20x1.40mm_HandSolder
R10, R11, R12, R13: 20k; R_0805_2012Metric_Pad1.20x1.40mm_HandSolder
R18, R19, R20, R21: 1R; R_0805_2012Metric_Pad1.20x1.40mm_HandSolder
R22, R23, R24, R25: 1k; R_1206_3216Metric_Pad1.30x1.75mm_HandSolder
R26, R27: 4k7; R_0805_2012Metric_Pad1.20x1.40mm_HandSolder
RV1: 2k; Potentiometer_Bourns_3296W_Vertical
TP1, TP2, TP3, TP4, TP5, TP6, TP7, TP8, TP9: TestPoint; TestPoint_Pad_D1.5mm
U1: Pico 2; RaspberryPi_Pico2_Sockets
U2: TPS7A2033PDBV; SOT-23-5
U3: MAX5026EUT; SOT-23-6

Connections:
+3.3VA: C4.1, R18.1, R19.1, R20.1, R21.1, TP2.1 (1_1), U2.5 (OUT)
/+3V3A_1: J1.4, R18.2
/+3V3A_2: J2.4, R19.2
/+3V3A_3: J3.4, R20.2
/+3V3A_4: J4.4, R21.2
/+3V3_PICO: C18.1, C19.1, J5.1, J6.1, R26.1, R27.1, U1.36 (3V3)
/+5V: C1.1, C2.1, C3.1, C5.1, FB1.2, L1.1, R1.1, TP1.1 (1_1), U2.1 (IN), U2.3 (EN), U3.5 (VCC)
/HV: C7.1, R4.2, R6.1, R22.1, R23.1, R24.1, R25.1, TP3.1 (1_1)
/HV1: C14.1, J1.1, R22.2
/HV2: C15.1, J2.1, R23.2
/HV3: C16.1, J3.1, R24.2
/HV4: C17.1, J4.1, R25.2
/HV_DIV: R3.2, RV1.1
/HV_EN: R5.1, U1.14 (GP10), U3.4 (SHDN)
/HV_FB: R2.2, R3.1, R8.1, U3.3 (FB)
/HV_MON: C8.1, R6.2, R7.1, U1.31 (GP26_ADC0)
/HV_RAW: C6.1, D1.1 (K), R2.1, R4.1
/HV_TRIM: C9.1, R8.2, R9.1
/HV_TRIM_PWM: R9.2, U1.15 (GP11)
/I2C_SCL: J5.4, R27.2, U1.27 (GP21)
/I2C_SDA: J5.3, R26.2, U1.26 (GP20)
/LX: D1.2 (A), L1.2, U3.6 (LX)
/OUT1: J1.6, U1.4 (GP2)
/OUT2: J2.6, U1.5 (GP3)
/OUT3: J3.6, U1.6 (GP4)
/OUT4: J4.6, U1.7 (GP5)
/SD_CS: J6.6, U1.22 (GP17)
/SD_MISO: J6.5, U1.21 (GP16)
/SD_MOSI: J6.4, U1.25 (GP19)
/SD_SCK: J6.3, U1.24 (GP18)
/THR1: C10.1, J1.3, R10.2, R14.1, TP4.1 (1_1)
/THR1_PWM: R10.1, U1.9 (GP6)
/THR2: C11.1, J2.3, R11.2, R15.1, TP5.1 (1_1)
/THR2_PWM: R11.1, U1.10 (GP7)
/THR3: C12.1, J3.3, R12.2, R16.1, TP6.1 (1_1)
/THR3_PWM: R12.1, U1.11 (GP8)
/THR4: C13.1, J4.3, R13.2, R17.1, TP7.1 (1_1)
/THR4_PWM: R13.1, U1.12 (GP9)
/UART_RX: J7.3, U1.2 (GP1)
/UART_TX: J7.2, U1.1 (GP0)
/VBUS: FB1.1, U1.40 (VBUS)
GND: C1.2, C2.2, C3.2, C4.2, C5.2, C6.2, C7.2, C8.2, C9.2, C10.2, C11.2, C12.2, C13.2, C14.2, C15.2, C16.2, C17.2, C18.2, C19.2, J1.2, J1.5, J2.2, J2.5, J3.2, J3.5, J4.2, J4.5, J5.2, J6.2, J7.1, R1.2, R5.2, R7.2, R14.2, R15.2, R16.2, R17.2, RV1.2, RV1.3, TP8.1 (1_1), TP9.1 (1_1), U1.3 (GND), U1.8 (GND), U1.13 (GND), U1.18 (GND), U1.23 (GND), U1.28 (GND), U1.33 (AGND), U1.38 (GND), U2.2 (GND), U3.1 (PGND), U3.2 (GND)

Notes on the sheet:
1. 5 V input and 3.3 V analog supply
R1: dummy load for power banks, not fitted
TP8, TP9: ground
2. SiPM bias: MAX5026 step-up, 22 - 28 V
R5 keeps the bias OFF until the Pico drives HV_EN high
L1: 47 uH, saturation current above 0.35 A. D1: Schottky, 40 V. R2, R3, RV1 set the voltage
HV_MON = HV / 11, to the Pico ADC
R8 not fitted: option to trim the bias from software (temperature compensation)
3. Raspberry Pi Pico 2
6. Pressure sensor, microSD, debug
4. Thresholds: PWM / 3, filtered. 0 - 1.1 V
5. Channel connectors: 1 HV, 2 GND, 3 THR, 4 +3V3A, 5 GND, 6 OUT (straight cable, pin 1 to pin 1)

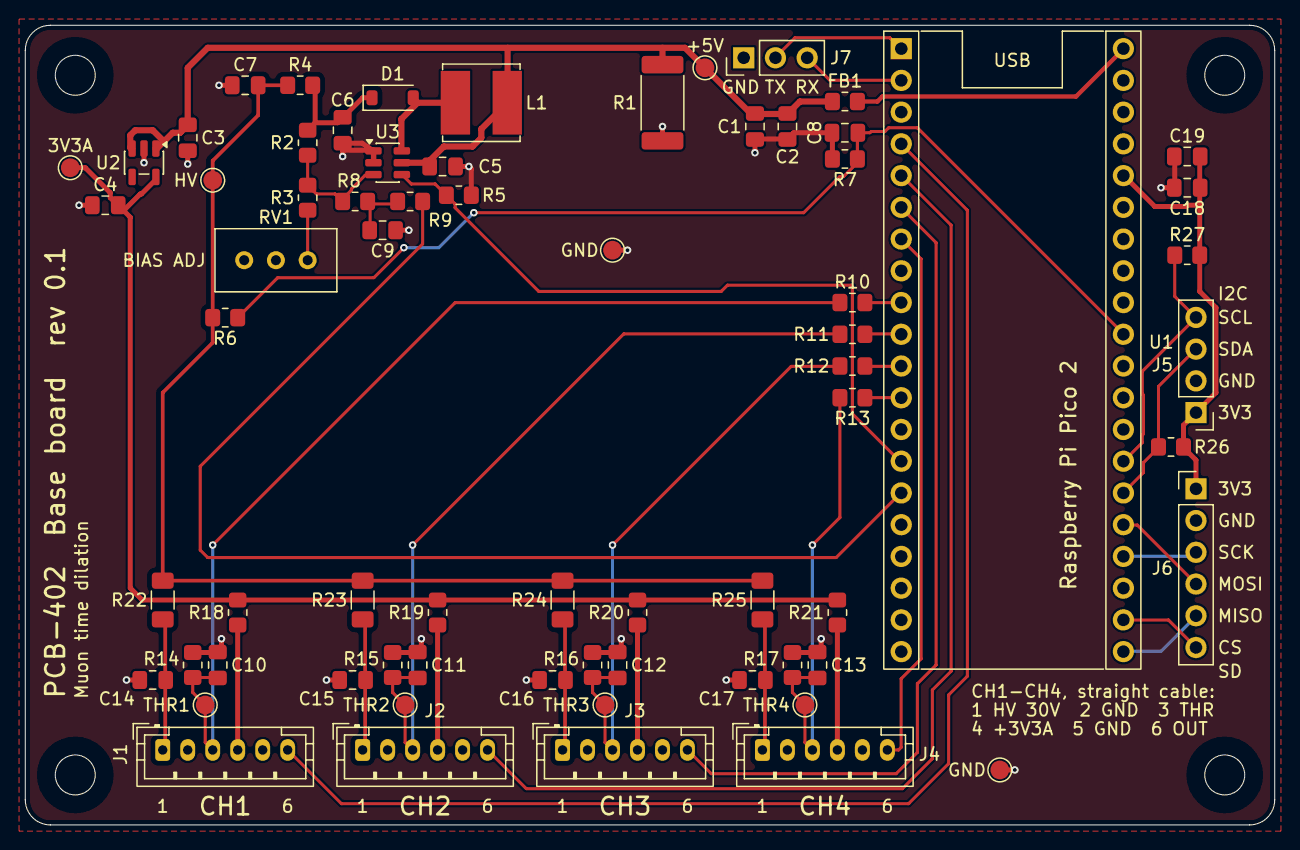
[picture p35: board PCB-402_base_board.kicad_pcb from above]

Board: 2 copper layers, 100.0 x 64.0 mm, 73 parts (0 on the bottom side), 42 nets.

Other parts of the board:
H1, H2, H3, H4: M3; MountingHole_3.2mm_M3
