LollobolUni/muon-time-dilation/hardware/kicad/PCB-401_front-end_channel_board/PCB-401_front-end_channel_board.kicad_pcb

## KiCad design hardware/kicad/PCB-401_front-end_channel_board/PCB-401_front-end_channel_board.kicad_pcb (2026-11-06)

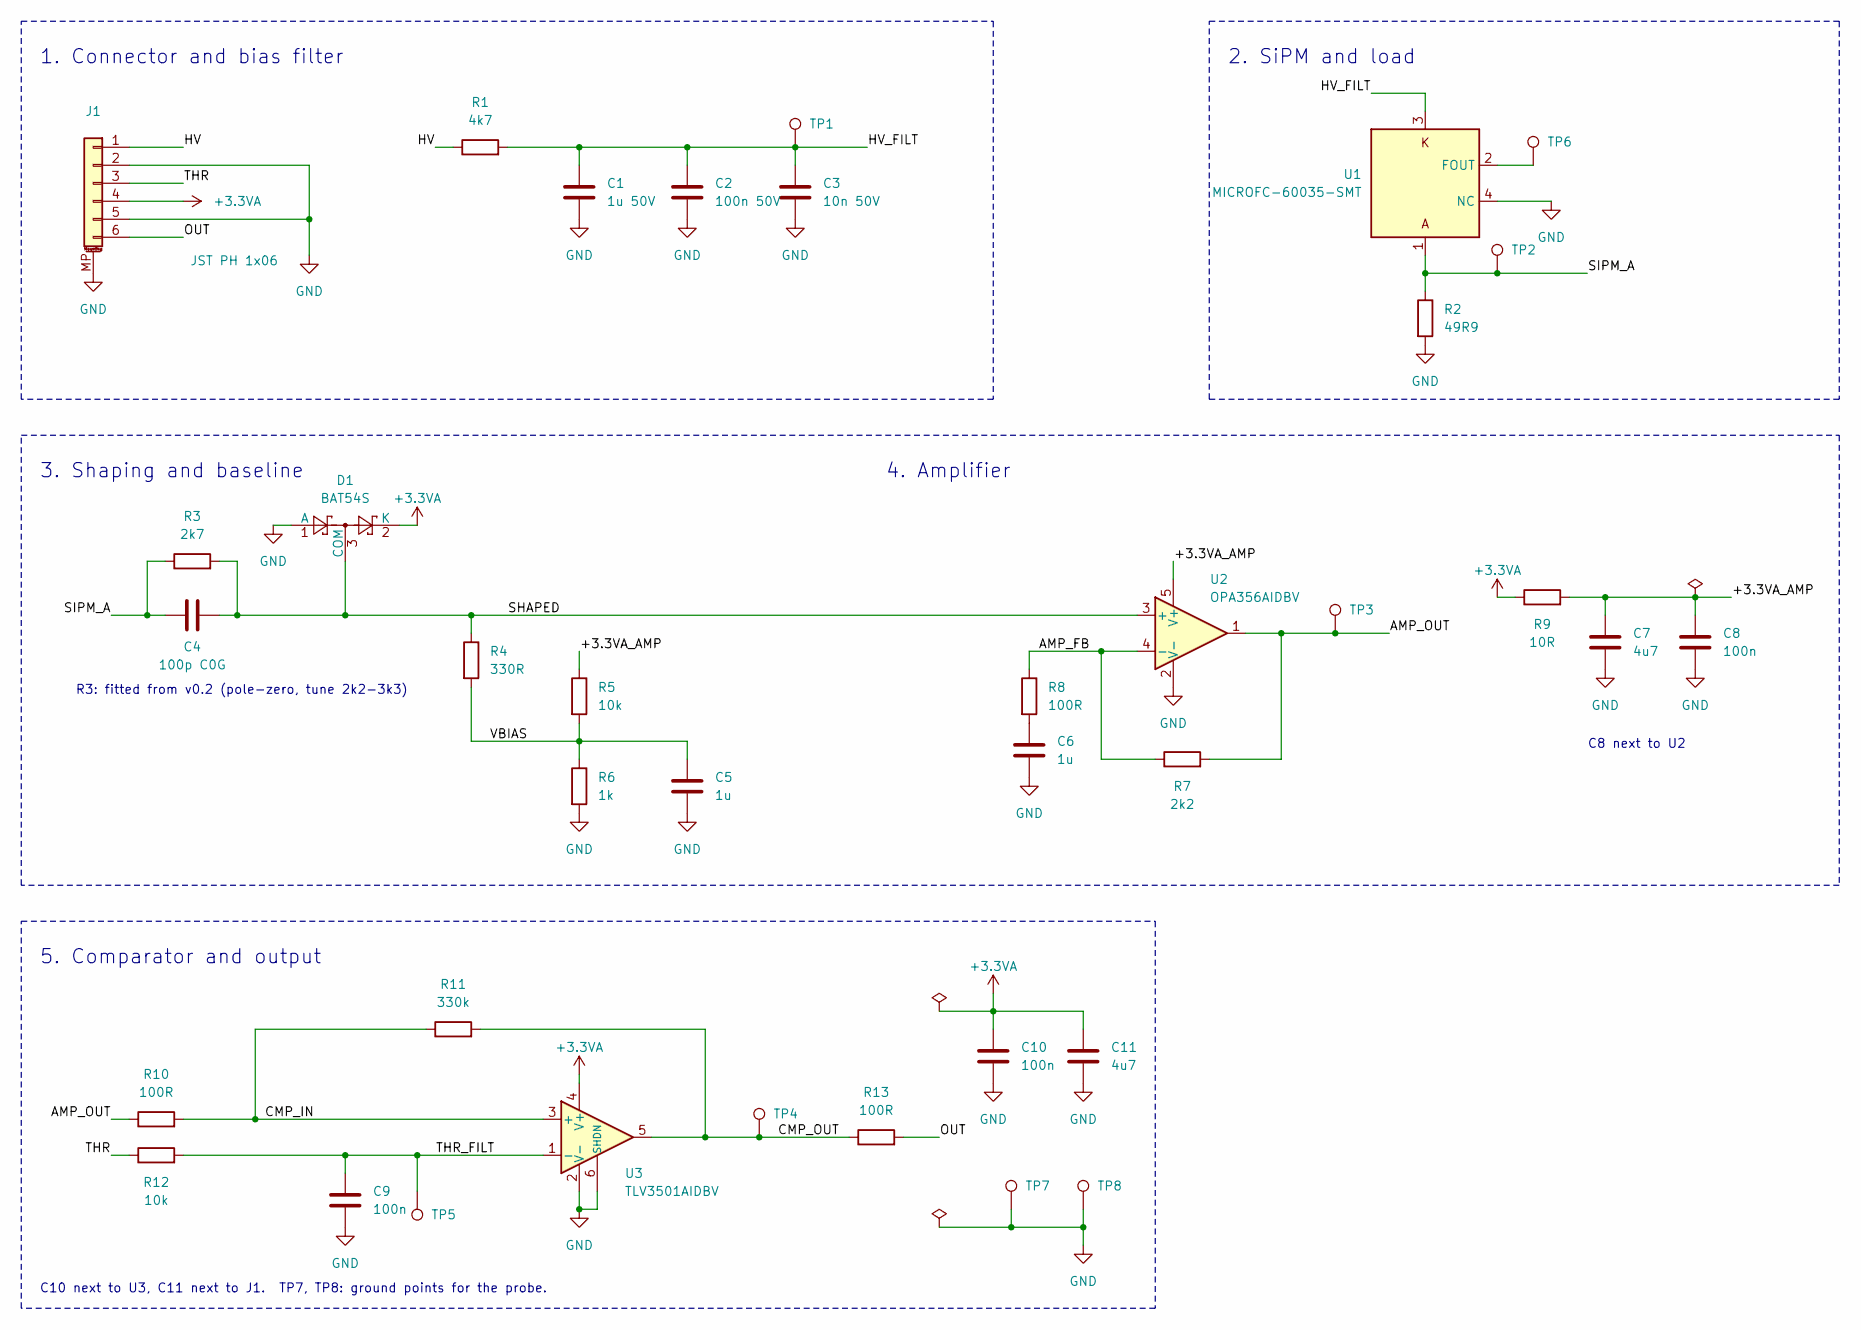
[picture p36: schematic PCB-401_front-end_channel_board.kicad_sch, Front-end channel board]

Parts:
C1: 1u 50V; C_0805_2012Metric_Pad1.18x1.45mm_HandSolder
C2: 100n 50V; C_0805_2012Metric_Pad1.18x1.45mm_HandSolder
C3: 10n 50V; C_0805_2012Metric_Pad1.18x1.45mm_HandSolder
C4: 100p C0G; C_0805_2012Metric_Pad1.18x1.45mm_HandSolder
C5, C6: 1u; C_0805_2012Metric_Pad1.18x1.45mm_HandSolder
C7, C11: 4u7; C_0805_2012Metric_Pad1.18x1.45mm_HandSolder
C8, C9, C10: 100n; C_0805_2012Metric_Pad1.18x1.45mm_HandSolder
D1: BAT54S; SOT-23
J1: JST PH 1x06; JST_PH_S6B-PH-SM4-TB_1x06-1MP_P2.00mm_Horizontal
R1: 4k7; R_0805_2012Metric_Pad1.20x1.40mm_HandSolder
R2: 49R9; R_0805_2012Metric_Pad1.20x1.40mm_HandSolder
R3: 2k7; R_0805_2012Metric_Pad1.20x1.40mm_HandSolder
R4: 330R; R_0805_2012Metric_Pad1.20x1.40mm_HandSolder
R5, R12: 10k; R_0805_2012Metric_Pad1.20x1.40mm_HandSolder
R6: 1k; R_0805_2012Metric_Pad1.20x1.40mm_HandSolder
R7: 2k2; R_0805_2012Metric_Pad1.20x1.40mm_HandSolder
R8, R10, R13: 100R; R_0805_2012Metric_Pad1.20x1.40mm_HandSolder
R9: 10R; R_0805_2012Metric_Pad1.20x1.40mm_HandSolder
R11: 330k; R_0805_2012Metric_Pad1.20x1.40mm_HandSolder
TP1, TP2, TP3, TP4, TP5, TP6, TP7, TP8: TestPoint; TestPoint_Pad_D1.5mm
U1: MICROFC-60035-SMT
U2: OPA356AIDBV; SOT-23-5
U3: TLV3501AIDBV; SOT-23-6

Connections:
+3.3VA: C10.1, C11.1, D1.2 (K), J1.4, R9.1, U3.4 (V+)
/+3.3VA_AMP: C7.1, C8.1, R5.1, R9.2, U2.5 (V+)
/AMP_FB: R7.1, R8.1, U2.4 (-)
/AMP_OUT: R7.2, R10.1, TP3.1 (1_1), U2.1
/CMP_IN: R10.2, R11.1, U3.3 (+)
/CMP_OUT: R11.2, R13.1, TP4.1 (1_1), U3.5
/HV: J1.1, R1.1
/HV_FILT: C1.1, C2.1, C3.1, R1.2, TP1.1 (1_1), U1.3
/OUT: J1.6, R13.2
/SHAPED: C4.2, D1.3 (COM), R3.2, R4.1, U2.3 (+)
/SIPM_A: C4.1, R2.1, R3.1, TP2.1 (1_1), U1.1
/THR: J1.3, R12.1
/THR_FILT: C9.1, R12.2, TP5.1 (1_1), U3.1 (-)
/VBIAS: C5.1, R4.2, R5.2, R6.1
GND: C1.2, C2.2, C3.2, C5.2, C6.2, C7.2, C8.2, C9.2, C10.2, C11.2, D1.1 (A), J1.2, J1.5, J1.MP (MountPin), R2.2, R6.2, TP7.1 (1_1), TP8.1 (1_1), U1.4 (NC), U2.2 (V-), U3.2 (V-), U3.6 (SHDN)
unnamed: C6.1, R8.2
unnamed: TP6.1 (1_1), U1.2 (FOUT)

Notes on the sheet:
2. SiPM and load
C8 next to U2
4. Amplifier
3. Shaping and baseline
5. Comparator and output
C10 next to U3, C11 next to J1. TP7, TP8: ground points for the probe.
1. Connector and bias filter
R3: fitted from v0.2 (pole-zero, tune 2k2-3k3)

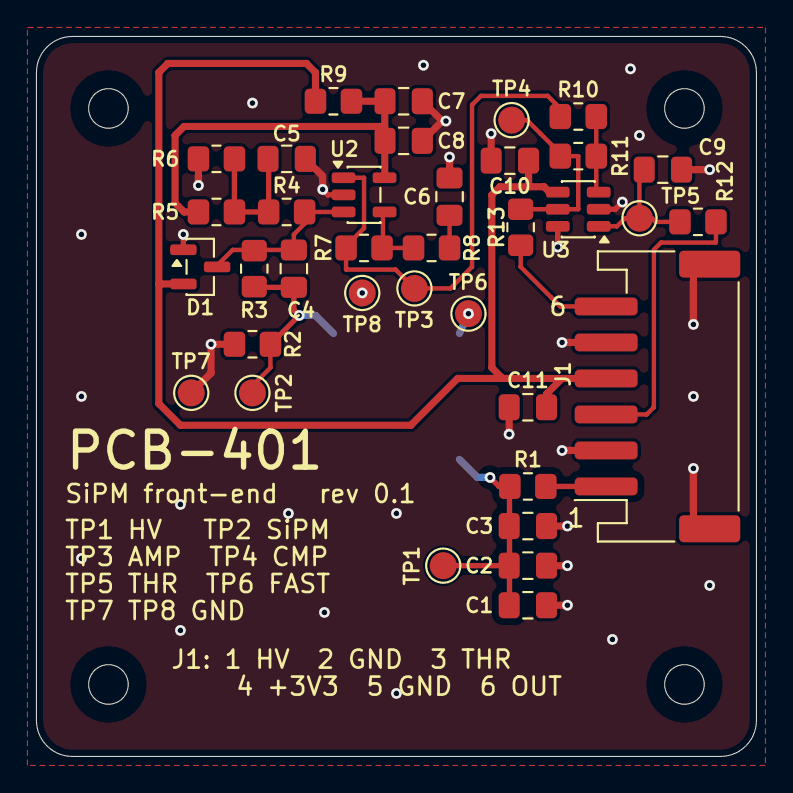
[picture p37: board PCB-401_front-end_channel_board.kicad_pcb from above]

Board: 2 copper layers, 40.0 x 40.0 mm, 41 parts (1 on the bottom side), 17 nets.

Other parts of the board:
H1, H2, H3, H4: MountingHole_2.2mm_NPTH
